raffsalvetti/ENGG60/projeto/Lista de símbolos.txt

$\theta$            Ângulo de Rotação
$\Delta_x$          Componente $x$ do Vetor de Rotação
$\Delta_y$          Componente $y$ do Vetor de Rotação
$\Delta_z$          Componente $z$ do Vetor de Rotação
$\Omega$            Ohm
V                   Volts
$\degree$           Grau
