raffsalvetti/ENGG60/projeto/pos-textuais/apendices.tex

% APÊNDICES--------------------------------------------------------------------

\begin{apendicesenv}
\partapendices

\includepdf[pages=-,offset=0 -20,angle=-90,scale=0.9,pagecommand={
	\chapter{Diagrama de Circuitos} % Edite para alterar o título deste apêndice
	\label{chap:board}
}]{../board/hat.pdf}

\chapter{Fotos do Protótipo} % Edite para alterar o título deste apêndice
\label{chap:fotosprototipo}

\begin{figure}[H]
	\centering
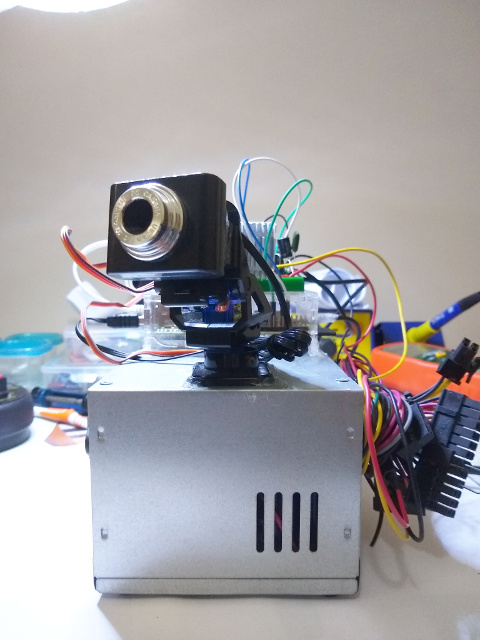
[picture p1: projeto/figuras/vista_frontal.jpg]
	
	\caption{Visão anterior.}
	\label{fig:vistafrontal}
\end{figure}

\begin{figure}[H]
	\centering
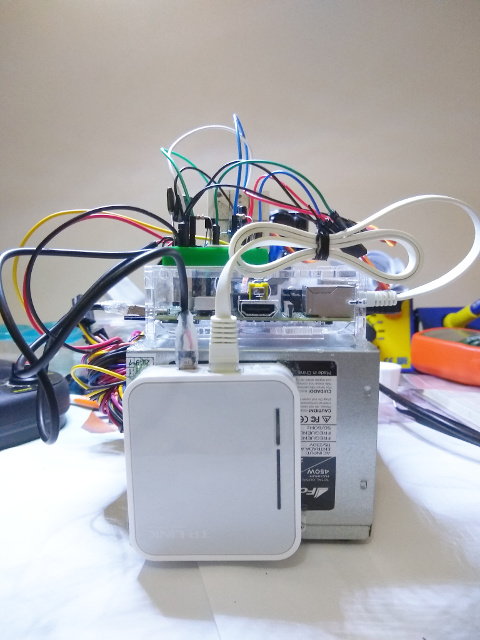
[picture p2: projeto/figuras/vista_traseira.jpg]
	
	\caption{Visão posterior.}
	\label{fig:vistatraseira}
\end{figure}

\begin{figure}[H]
	\centering
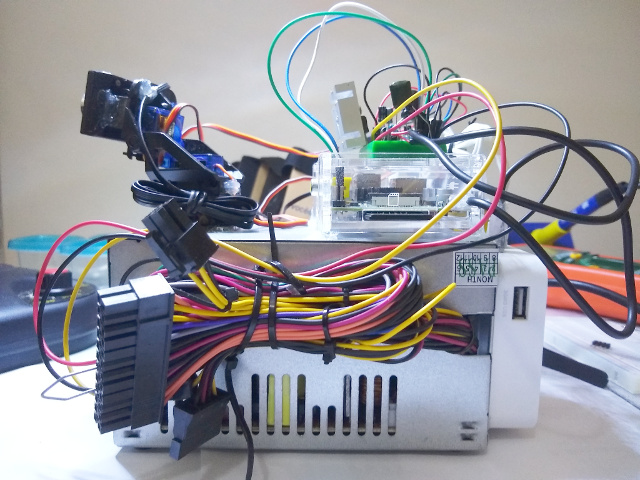
[picture p3: projeto/figuras/vista_esquerda.jpg]
	
	\caption{Visão lateral esquerda.}
	\label{fig:vistaesquerda}
\end{figure}

\begin{figure}[H]
	\centering
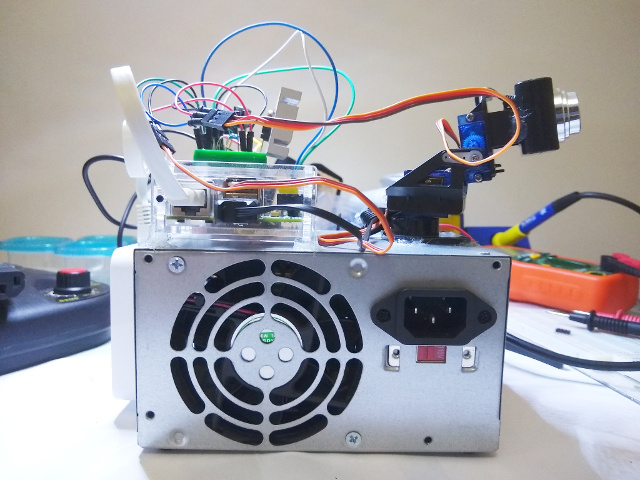
[picture p4: projeto/figuras/vista_direita.jpg]
	
	\caption{Visão lateral direita.}
	\label{fig:vistadireita}
\end{figure}

\begin{figure}[H]
	\centering
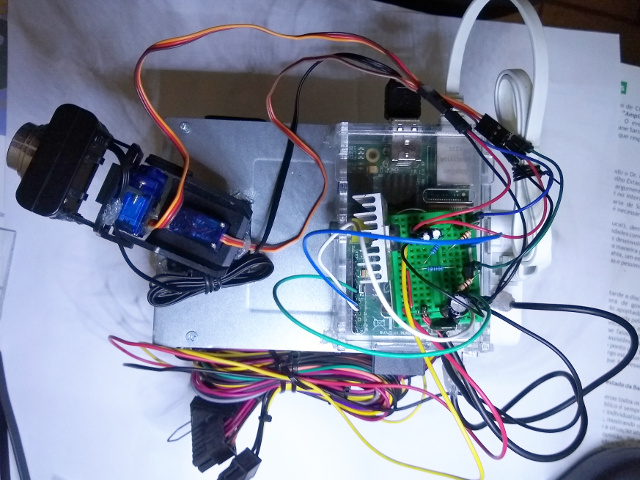
[picture p5: projeto/figuras/vista_superior.jpg]
	
	\caption{Visão superior.}
	\label{fig:vistasuperior}
\end{figure}

\begin{figure}[H]
	\centering
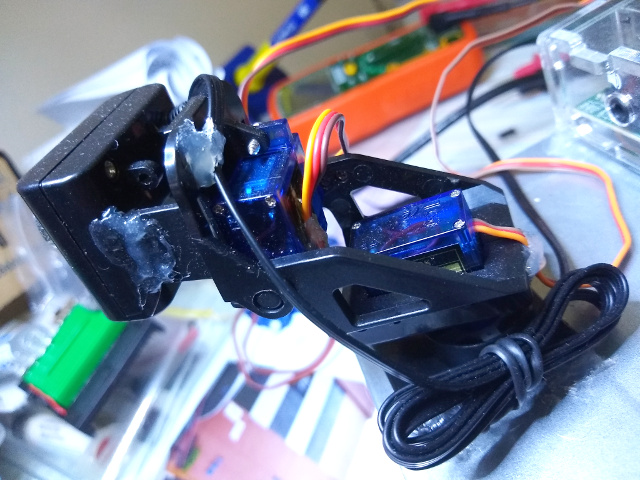
[picture p6: projeto/figuras/vista_detalhe_fixacao_camera.jpg]
	
	\caption{Fixação da câmera com cola quente.}
	\label{fig:vistadetalhefixacaocamera}
\end{figure}

\begin{figure}[H]
	\centering
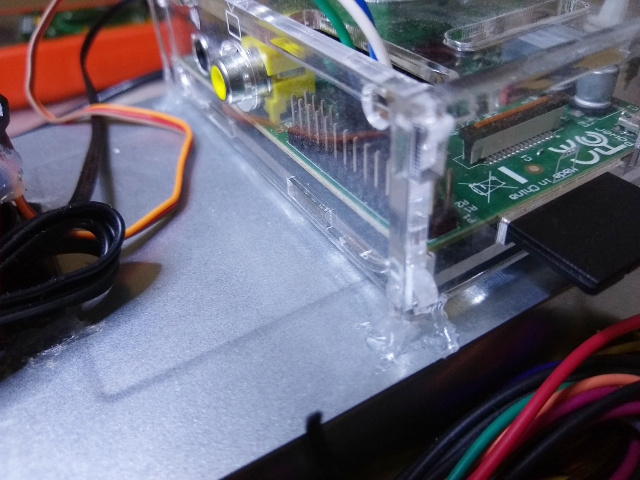
[picture p7: projeto/figuras/vista_detalhe_fixacao_raspi.jpg]
	
	\caption{Fixação do gabinete do \textit{Raspberry Pi} com cola quente.}
	\label{fig:vistadetalhefixacaoraspi}
\end{figure}

\begin{figure}[H]
	\centering
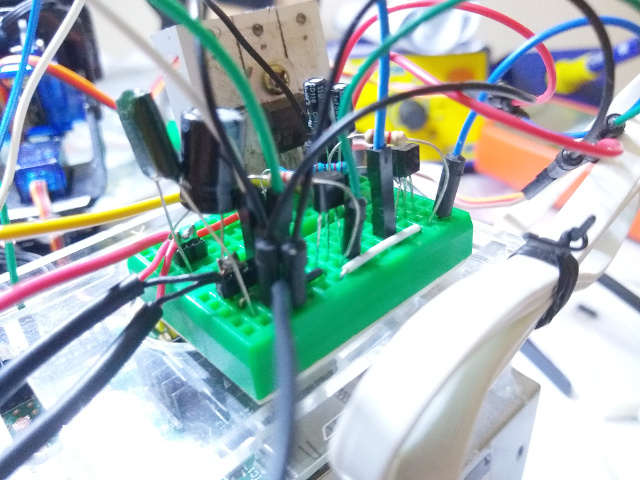
[picture p8: projeto/figuras/vista_detalhe_circuito.jpg]
	
	\caption{Detalhe da montagem do circuito na mini \textit{breadboard}.}
	\label{fig:vistadetalhecircuito}
\end{figure}

\end{apendicesenv}
