raffsalvetti/ENGG60/projeto/pre-textuais/lista-siglas.tex

% LISTA DE ABREVIATURAS E SIGLAS----------------------------------------------------------

\begin{siglas}
	\item[API]         Application Programming Interface
	\item[ARM]         Advanced RISC Machine
	\item[ATX]         Advanced Technology eXtended
	\item[DOF]         Degrees of freedom
	\item[GPIO]        General-Purpose Input/Output
	\item[HAL]         Hardware Abstraction Layer
	\item[IP]          Internet Protocol
	\item[MCC]         Módulo de Controle de Câmera
	\item[MCM]         Módulo de Captura de Movimento
	\item[PAN]         Panning
	\item[PSU]         Power Supply Unit
	\item[PWM]         Pulse-Width Modulation
	\item[RAM]         Random Access memory
	\item[ROS]		   Robot Operating System
	\item[RTP]         Real Time Protocol
	\item[SoC]         System on Chip
	\item[TCP]         Transmission Control Protocol
	\item[TILT]        Tilting
	\item[VLC]         VideoLAN Client
	\item[VR]          Virtual Reality
\end{siglas}

% OBSERVAÇÕES-----------------------------------------------------------------------------
% Altere a lista acima para definir os acrônimos e siglas utilizados neste trabalho
