raffsalvetti/ENGG60/apresentacao/tcc.odp

## UNIVERSIDADE FEDERAL DA BAHIA ESCOLA POLITÉCNICA CURSO DE GRADUAÇÃO EM ENGENHARIA DE COMPUTAÇÃO

## CONTROLE DO MOVIMENTO DE CÂMERA COM BASE EM SENSORES DE MOVIMENTO DE UM SMARTPHONE

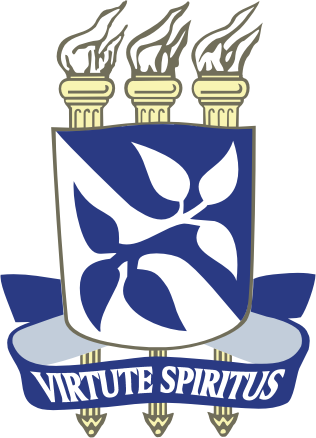
[picture p32: figure]

Autor: Raffaello Salvetti Santos

Orientador: Prof. Paulo César Machado de Abreu Farias

Salvador (BA), Dezembro de 2019

## Introdução

- Uso de robôs está cada vez mais popular.
- A complexidade de operação de um robô é proporcional ao seu DOF.
- uma câmera controlada independentemente da orientação de um robô, pode facilitar tarefas de localização num ambiente.

## Objetivos

- Redução da complexidade de controle de um robô.
- Controle intuitiva de câmera.
- Imersividade do operador.

## Inspiração

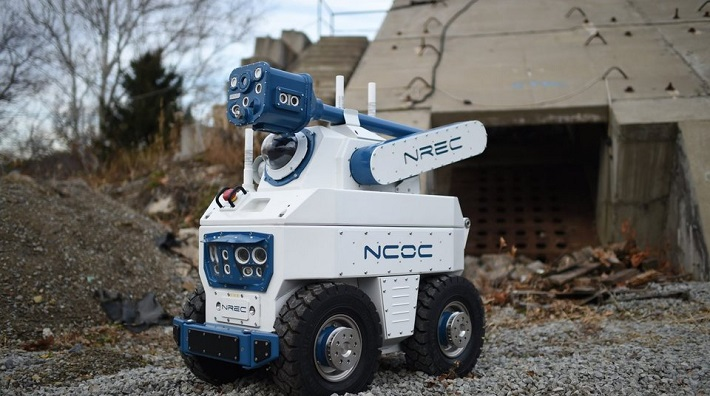
[picture p33: figure]

SENSABOT

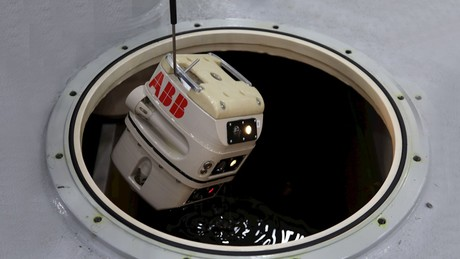
[picture p34: figure]

ABB

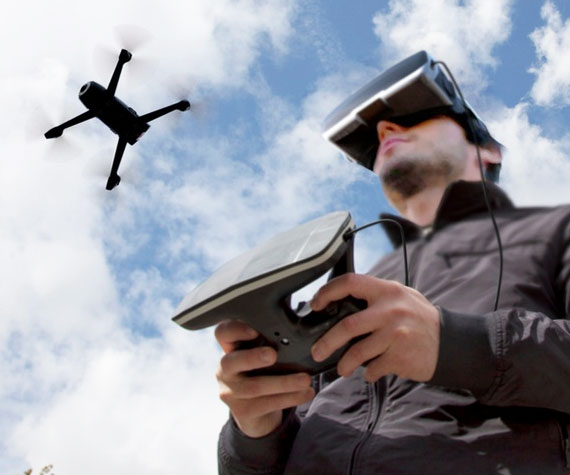
[picture p35: figure]

Sistema FPV

## Conceito - Cardboard


Smartphone Android


Óculos VR (Google Cardboard)

## Conceito – Controlador


Raspberry Pi

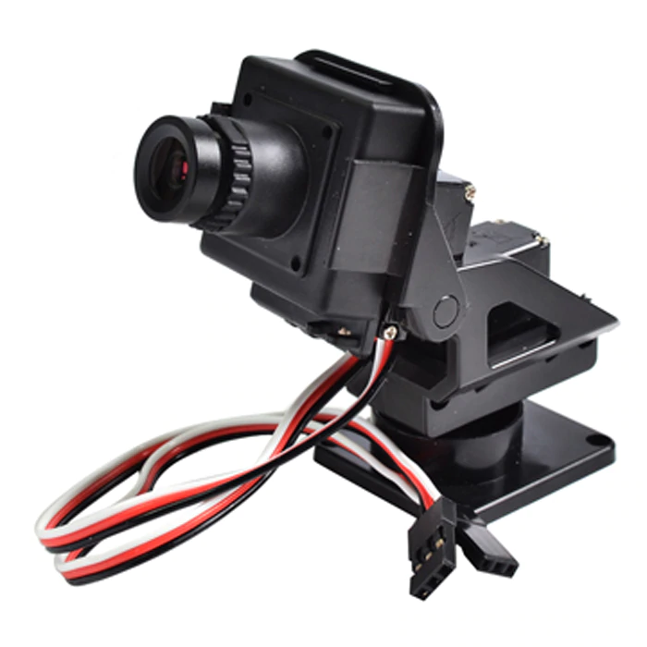
[picture p36: figure]

CÂMERA COM MONTAGEM E SERVO MOTORES

## Conceito - Funcionamento

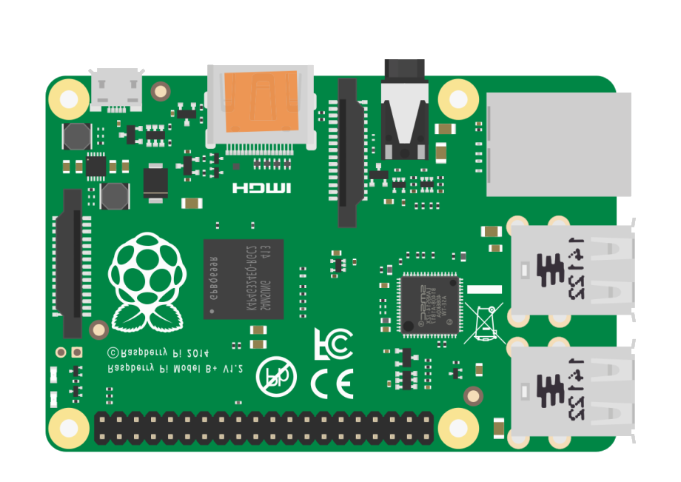
[picture p37: figure]
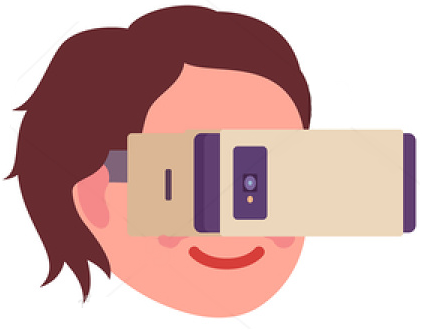
[picture p38: figure]
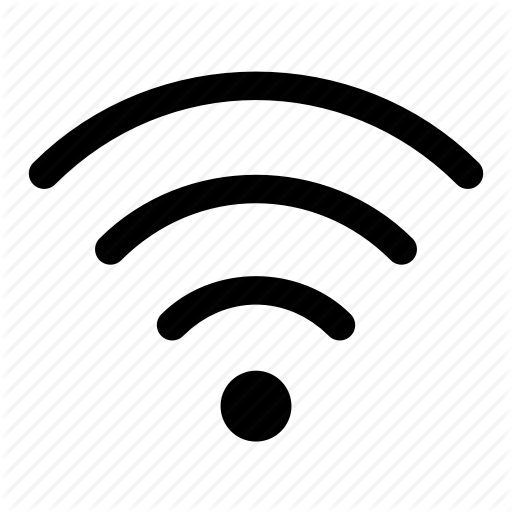
[picture p39: figure]
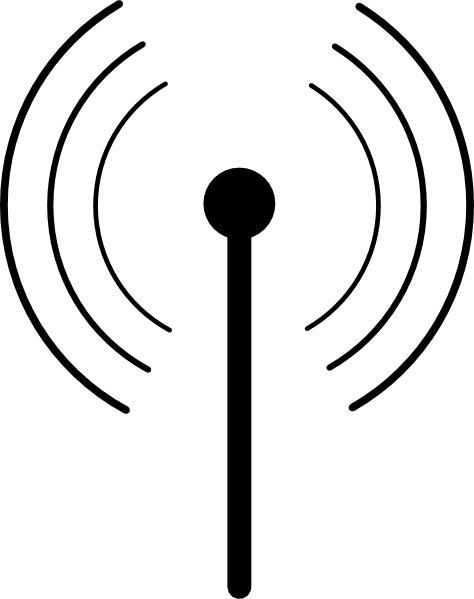
[picture p40: figure]
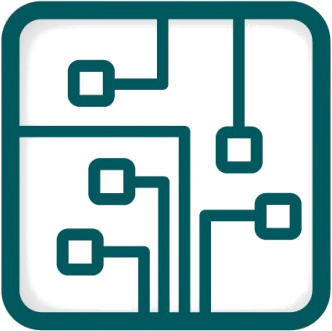
[picture p41: figure]
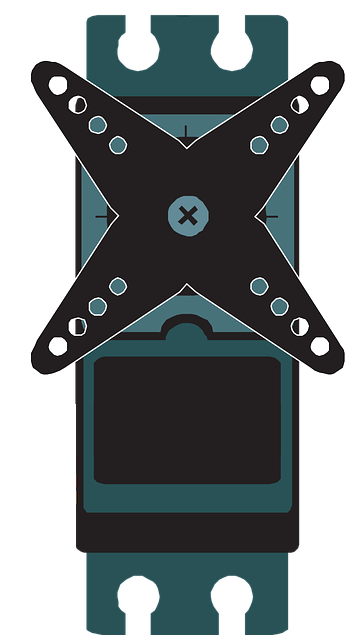
[picture p42: figure]
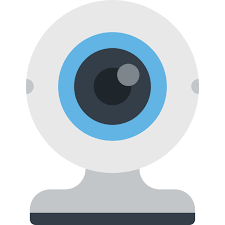
[picture p43: figure]

## Conceito – Tradução de Movimentos

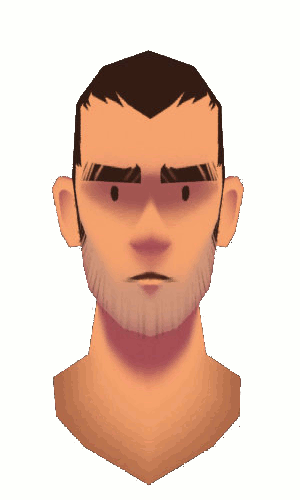
[picture p44: figure]
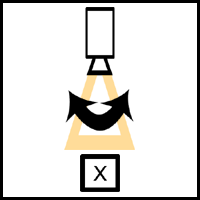
[picture p45: figure]
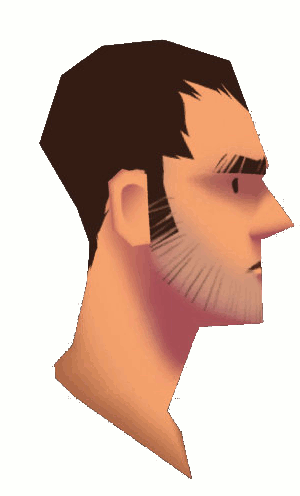
[picture p46: figure]
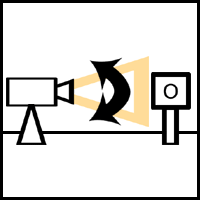
[picture p47: figure]

## Protótipo

- Construção de circuito de teste para os servo motores;
- Teste de frequência de operação e estabilidade dos servo motores;
- Construção de circuitos de acionamento e alimentação;
- Construção do protótipo;
- Programação dos softwares;
- Testes gerais.

## Protótipo – Driver PWM

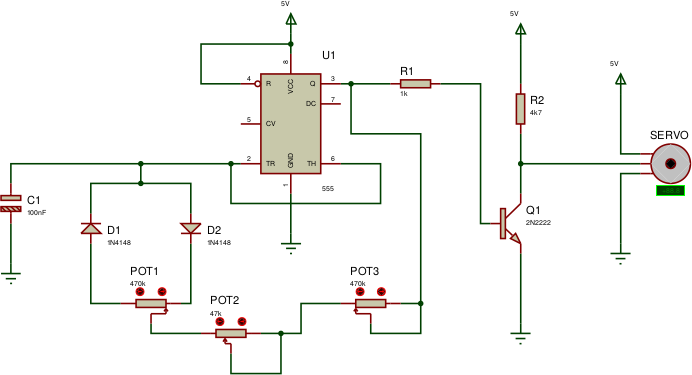
[picture p48: figure]

Circuito de teste dos motores.

## Protótipo – Driver PWM Resultados dos Testes

- Estabilidade com frequências próximas a 50Hz.
- Instabilidade com variações da largura do pulso.

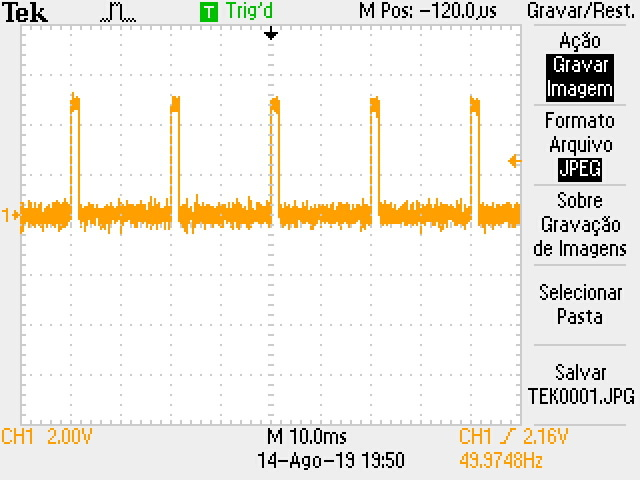
[picture p49: figure]

Teste do sinal com um osciloscópio.

## Protótipo – Circuitos de Acionamento e Alimentação

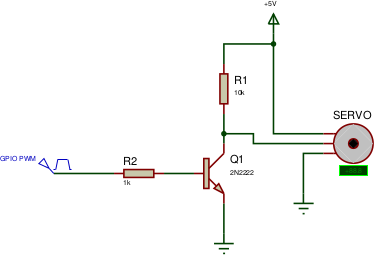
[picture p50: figure]

Circuito de Acionamento

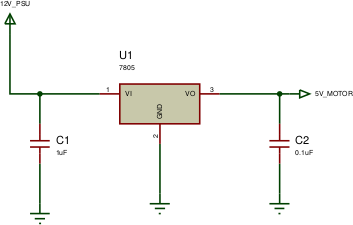
[picture p51: figure]

Circuito de Alimentação

## Protótipo – Montagem (Visão Lateral)


Visão lateral direita do protótipo.

## Protótipo – Montagem (Visão Superior)


Visão superior do protótipo.

## Protótipo – Montagem (Visões Posterior e Anterior)


Visão posterior do protótipo.


Visão anterior do protótipo.

## Programação - MCM


Interface com o usuário (operador) do MCM.

## Programação - MCC

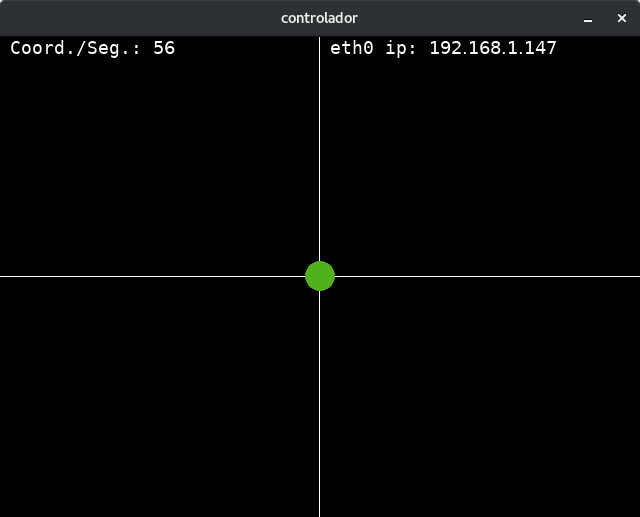
[picture p52: figure]

Interface de testes do MCC

## Programação – MCC (CAMDEMO)

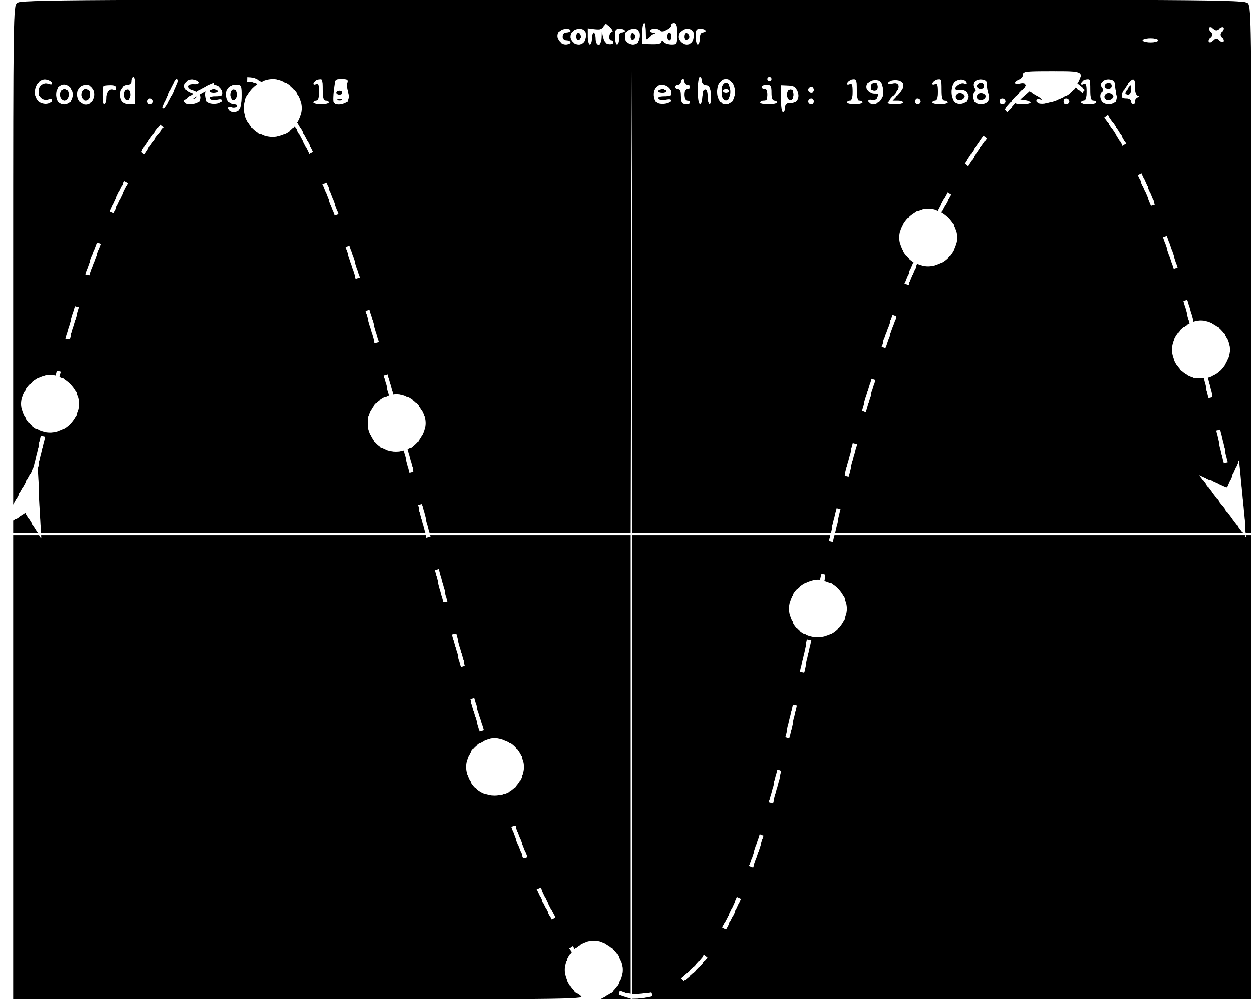
[picture p53: figure]

Função automática de teste dos motores (CAMDEMO)

## Testes Gerais

- Codecs de vídeo;
- Consumo de banda (dados de controle e imagens);
- Envio de imagem capturada pela câmera;
- Teste de servo motores.

## Teste – Codecs de Vídeo

Ffmpeg usando o codec de vídeo h264 (implementado em software).

Ffmpeg usando o codec de vídeo h264_omx (implementado em hardware).

## Teste – Consumo de Dados

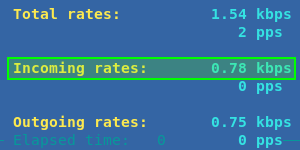
[picture p54: figure]

Envio de Coordenadas (Com Filtro).

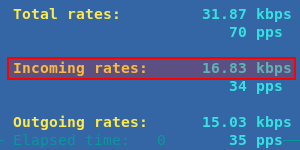
[picture p55: figure]

Envio de Coordenadas (Sem Filtro).

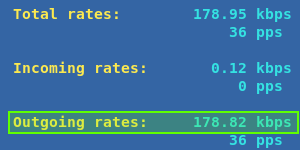
[picture p56: figure]

Envio de imagens de vídeo.

## Teste – Imagens da câmera


Imagem enviada pela câmera.

## Teste – Servo Motores

## Teste – Servo Motores Correção no movimento

## Resultados

## Conclusão

- Os testes demonstram que o sistema pode ser utilizado para reduzir a complexidade do controle global de um robô.
- O controle de câmera é realizado de forma intuitiva.
- É necessário aprimorar o sistema de transmissão de vídeo para que o operador tenha a sensação de imersividade.

## Referências

HUGHES, S.; LEWIS, M. Robotic camera control for remote exploration. In: ACM. Proceedings of the SIGCHI conference on Human factors in computing systems. [S.l.], 2004. p. 511-517.

AMADEO, R. Google’s iron grip on Android: Controlling open source by any means necessary. 2018. Disponível em:< https://arstechnica.com/gadgets/2018/07/googles-iron-grip-on-android-controlling-open-source-by-any-means-necessary/>.

ANDROID.COM. What is Android. 2019. Disponível em: <https://www.android.com/what-is-android>

DEVELOPERS, G. A. Motion sensors. 2019. Disponível em: <https://developer.android.com/guide/topics/sensors/sensors motion>

DOMAIN, P. Pan and Tilt. 2019. Disponível em: <https://pt.wikipedia.org/wiki/Panor%C3%A2mica (https://pt.wikipedia.org/wiki/Panorâmica)>

LAMPERT, K. Modular Head. 2019. Disponível em: <https://www.artstation.com/artwork/31rg>

PINCKNEY, N. Pulse-width modulation for microcontroller servo control. IEEE potentials, IEEE, v. 25, n. 1, p. 27-29, 2006.
