raffsalvetti/ENGG60/projeto/figuras/diagrama-modulos-eps-converted-to.pdf

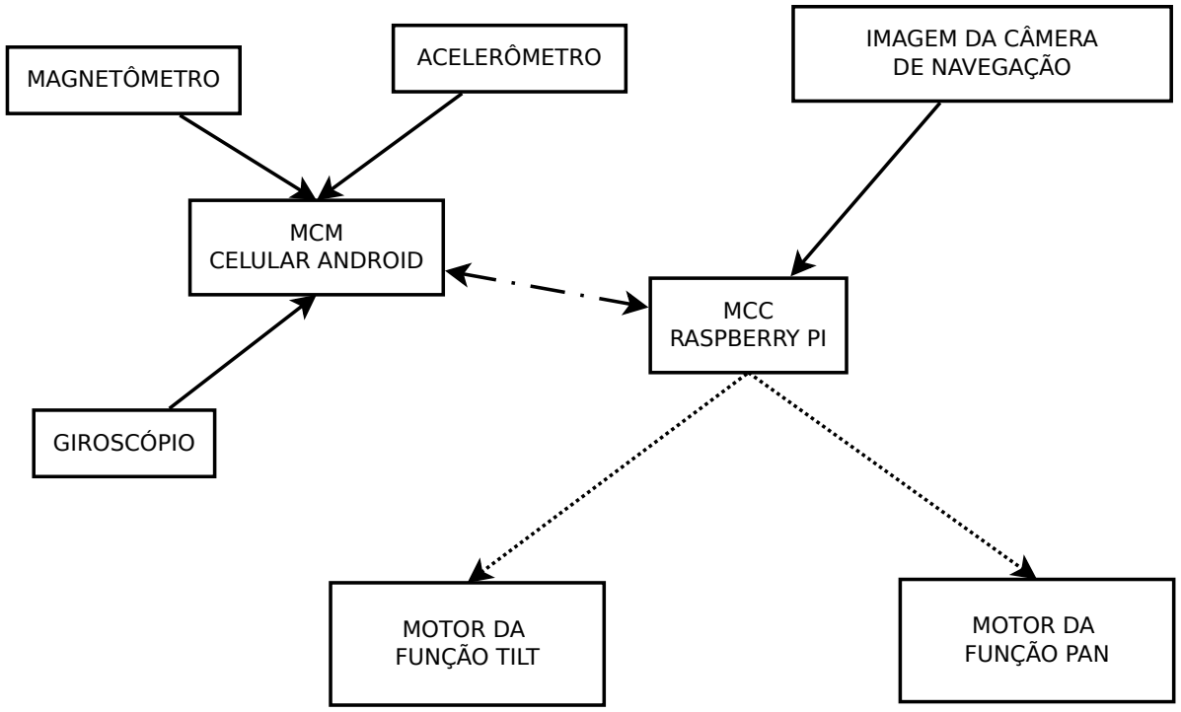
[picture p58: figure]
MCM CELULAR ANDROID; MCC RASPBERRY PI; MOTOR DA FUNÇÃO TILT; IMAGEM DA CÂMERA DE NAVEGAÇÃO; GIROSCÓPIO; MOTOR DA FUNÇÃO PAN; MAGNETÔMETRO; ACELERÔMETRO

LEGENDA:

COMUNICAÇÃO ETHERNET
COMUNICAÇÃO SERIAL
COMUNICAÇÃO PWM
