raffsalvetti/ENGG60/projeto/figuras/circ_acionamento.pdf

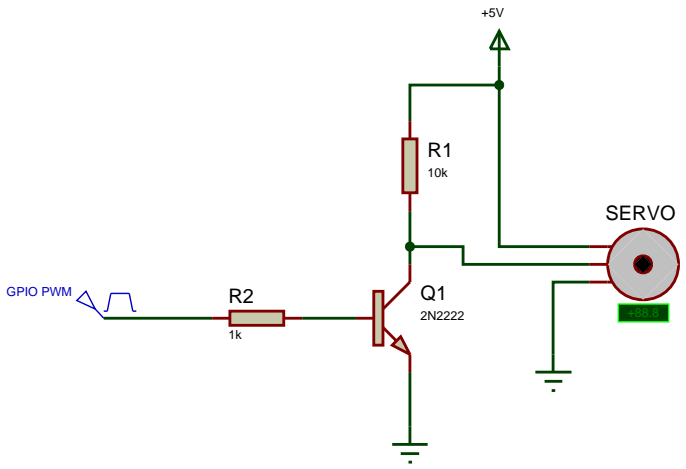
[picture p59: figure]
SERVO; GPIO PWM
