raffsalvetti/ENGG60/projeto/figuras/fonte_motores.pdf

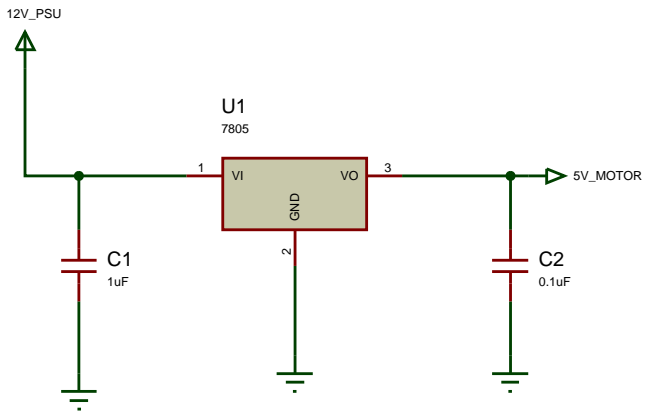
[picture p60: figure]
12V_PSU; GND 2; 5V_MOTOR
