raffsalvetti/ENGG60/projeto/pre-textuais/agradecimentos.tex

% AGRADECIMENTOS---------------------------------------------------------------

\begin{agradecimentos}[AGRADECIMENTOS]

Agradeço à Deus por permitir que eu chegasse até aqui. À minha família, em especial à minha mãe Sonia e ao meu pai Rui, que se esforçaram para me proporcionar conforto e educação. À minha irmã Alessandra, meus avós Lori e Luigi, às minhas tias Silvana e Zete, que incentivaram minha criatividade desde criança. À Mariana, minha companheira que sempre esteve ao meu lado, com bastante paciência, me apoiando e ajudando a vencer batalhas. Aos meus sogros Eugênio e Luiza, e cunhado Francisco que me acolheram e torceram muito por mim durante essa jornada. Aos meus amigos que estiveram junto também nas horas de dificuldade. Agradeço ao professor Heraldo, que muito contribuiu para minha formação intelectual e me apontou o caminho ainda no ensino médio. Ao meu orientador Paulo César, pelo suporte necessário para a realização deste trabalho. À Universidade Federal da Bahia e sua equipe de excelentes professores, com os quais tive a oportunidade de aprender. Por fim, agradeço aos meus colegas de curso, principalmente à Felipe, Luciano e Hugo, que tornaram essa caminhada mais descontraída.

\end{agradecimentos}
