raffsalvetti/ENGG60/projeto/pre-textuais/folha-aprovacao.tex

% ---
% Inserir folha de aprovação
% ---
% Isto é um exemplo de Folha de aprovação, elemento obrigatório da NBR
% 14724/2011 (seção 4.2.1.3). Você pode utilizar este modelo até a aprovação do trabalho. Após isso, substitua todo o conteúdo deste arquivo por uma imagem da página assinada pela banca com o comando abaixo:
%
% \includepdf{folhadeaprovacao_final.pdf}
%

%\dataaprovacao{00/00/0000}
%\conceito{} %Antes da defesa, não adicionar valor ao compo. Após a defesa, pode-se adicionar Regular, Bom ou Excelente e solicitar as assinaturas da banca examinadora.
 
\nomePrimeiromembro{Prof. Jés de Jesus Fiais Cerqueira}
\instPrimeiromembro{UFBA}
 
\nomeSegundomembro{Prof. Tiago Trindade Ribeiro}
\instSegundomembro{UFBA}

%Ocultar ou não dependendo do número de professores na banca. Ver arquivo de configuracao \assinatura{\imprimirnomeTerceiromembro  \\ Membro - \imprimirinstTerceiromembro}  nas configuracoes ufpa-fem-abntex2.cls.

%\nomeTerceiromembro{Eng. Beltrano Cunha} 
%\instTerceiromembro{Externo (PETROBRAS)}

%ª
