raffsalvetti/ENGG60/projeto/pre-textuais/lista-simbolos.tex

% LISTA DE SÍMBOLOS------------------------------------------------------------

\begin{simbolos}
    \item[$ \theta $] Ângulo de Rotação
    \item[$ \Delta_x $] Componente $x$ do Vetor de Rotação
    \item[$ \Delta_y $] Componente $y$ do Vetor de Rotação
    \item[$ \Delta_z $] Componente $z$ do Vetor de Rotação
    \item[$K\Omega$] Quilo-ohms
    \item[$V$] Volts
    \item[$mA$] Miliampere    
    \item[$\degree$] Grau
\end{simbolos}
% OBSERVAÇÕES-------------------------------------------------------------------
% Altere a lista acima para definir os símbolos utilizados no trabalho
