raffsalvetti/ENGG60/projeto/pre-textuais/capa.tex

% CAPA-------------------------------------------------------------------

% ORIENTAÇÕES GERAIS-------------------------------------------------------------------------------------
% Caso algum dos campos não se aplique ao seu trabalho, como por exemplo,
% se não houve coorientador, apenas deixe vazio.
% Exemplos: 
% \coorientador{}
% \departamento{}

% DADOS DO TRABALHO--------------------------------------------------------------------------------------
\titulo{\textbf{CONTROLE DO MOVIMENTO DE CÂMERA COM BASE EM SENSORES DE MOVIMENTO DE UM \textit{SMARTPHONE}}}
\subtitulo{} %Se não hover subtítulo, deixar em branco.
\titleabstract{CAMERA MOTION CONTROL BASED ON MOBILE PHONE SENSORS DATA}
\autor{RAFFAELLO SALVETTI SANTOS}
\autorcitacao{SALVETTI, Raffaello} % Sobrenome em maiúsculo
\local{SALVADOR/BA}
\data{2019}

% NATUREZA DO TRABALHO-----------------------------------------------------------------------------------
\projeto{Trabalho de Conclusão de Curso}

% TÍTULO ACADÊMICO---------------------------------------------------------------------------------------
\tituloAcademico{Bacharel}

% ÁREA DE CONCENTRAÇÃO E LINHA DE PESQUISA---------------------------------------------------------------
% Se a natureza for Trabalho de Conclusão de Curso, deixe ambos os campos vazios
% Se for programa de Pós-graduação, indique a área de concentração e a linha de pesquisa
\areaconcentracao{}
\linhapesquisa{}

% DADOS DA INSTITUIÇÃO-----------------------------------------------------------------------------------
% Se a natureza for Trabalho de Conclusão de Curso, coloque o nome do curso de graduação em "programa"
% Formato para o logo da Instituição: \logoinstituicao{<escala>}{<caminho/nome do arquivo>}
\instituicao{Universidade Federal da Bahia}
\departamento{Escola Politécnica}
\programa{Curso de Graduação em Engenharia de Computação}
\logoinstituicao{2cm}{figuras/naomexafig/logoufba.png} %

% DADOS DOS ORIENTADORES---------------------------------------------------------------------------------
\orientador{Prof. Paulo César Machado de Abreu Farias}
%\orientador[Orientadora:]{Nome da orientadora}
\instOrientador{Universidade Federal da Bahia}

%\coorientador{Nome do coorientador}
%\coorientador[Coorientadora:]{Nome da coorientadora}
%\instCoorientador{Instituição do coorientador}
