raffsalvetti/ENGG60/projeto/pos-textuais/naomexapostext/referencias.tex

% REFERÊNCIAS------------------------------------------------------------------

% Carrega o arquivo "base-referências.bib" e extrai automaticamente as referências citadas

\bibliography{./base-referencias}
\bibliographystyle{abntex2-alf} % Define o estilo ABNT para formatar a lista de referências
% OBSERVAÇÕES------------------------------------------------------------------
% Este arquivo não precisa ser alterado.
