raffsalvetti/ENGG60/projeto/pre-textuais/naomexapretext/folha-rosto.tex

% FOLHA DE ROSTO-------------------------------------------------------------------

% Este arquivo não precisa ser alterado

%% TRABALHO DE CONCLUSÃO DE CURSO
\preambulo{{\imprimirprojeto}, apresentado como parte dos requisitos para a obtenção de grau de {\imprimirtituloAcademico} em Engenharia de Computação, pela {\imprimirinstituicao}.}
