raffsalvetti/ENGG60/preprojeto/modelo.pdf

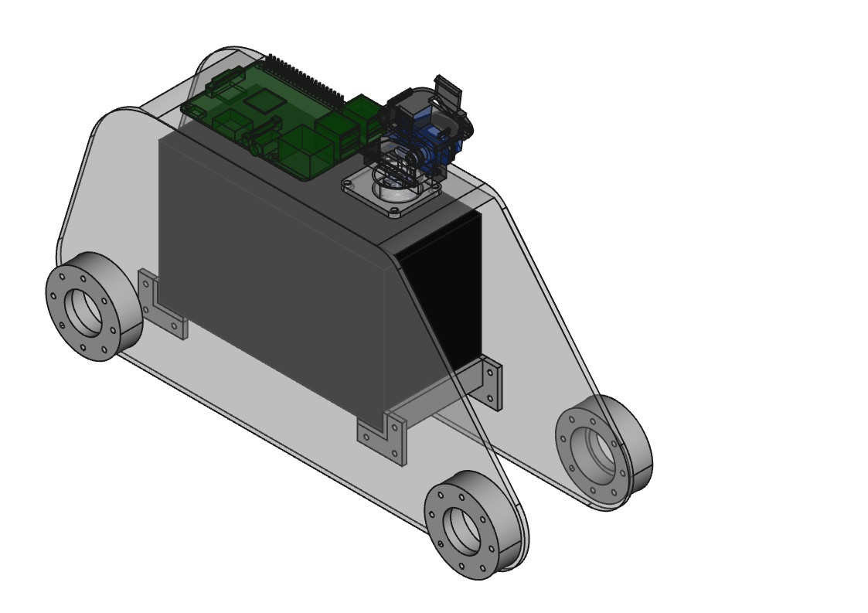
[picture p78: page 1]
