raffsalvetti/ENGG60/apresentacao/raspi.png

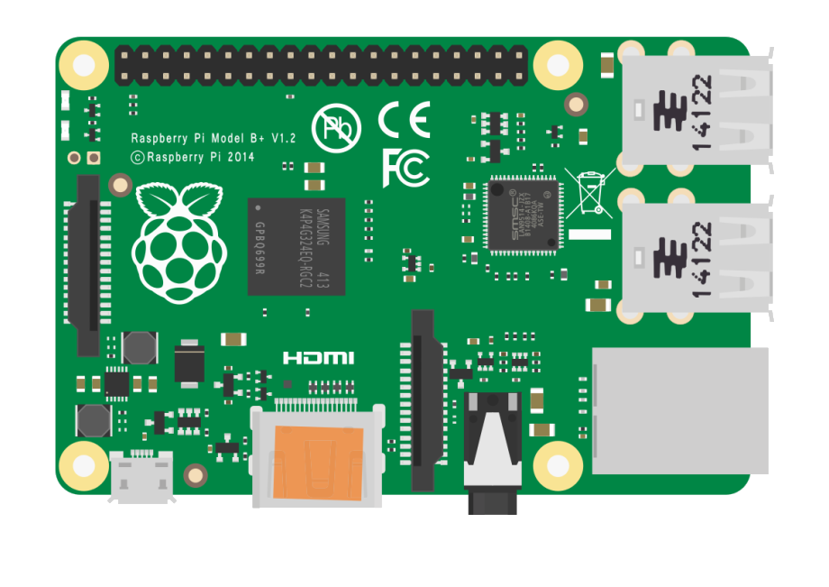
apresentacao/raspi.png
