raffsalvetti/ENGG60/apresentacao/SKEYE-Nano-drone.jpg

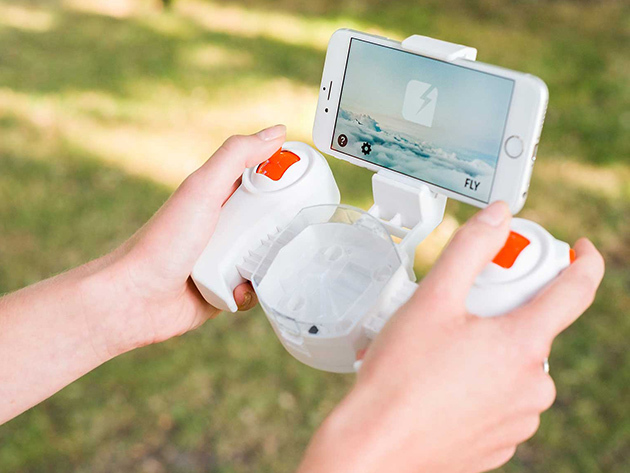
apresentacao/SKEYE-Nano-drone.jpg
