raffsalvetti/ENGG60/apresentacao/wireless.jpg

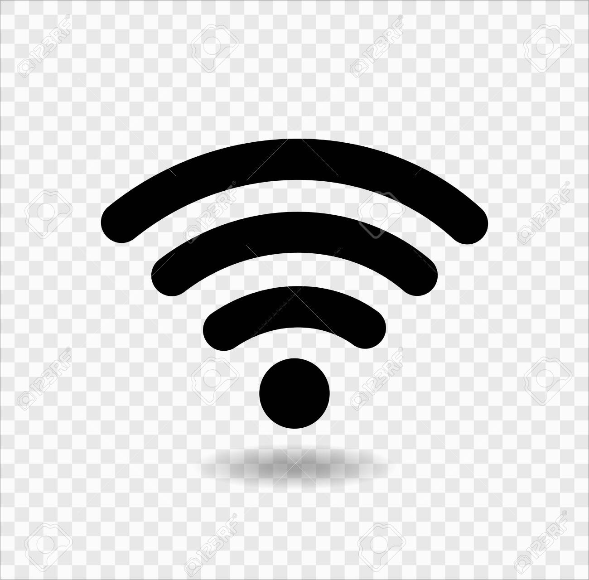
apresentacao/wireless.jpg
