raffsalvetti/ENGG60/projeto/figuras/arrow2.png

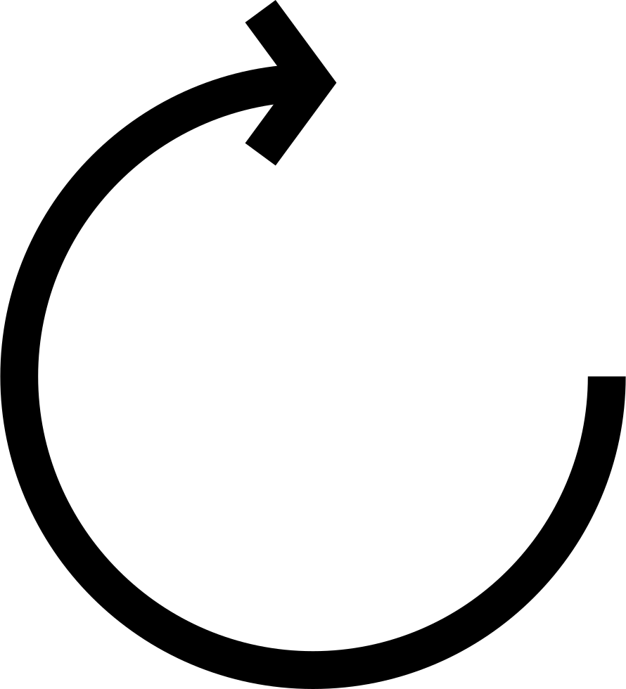
projeto/figuras/arrow2.png
