raffsalvetti/ENGG60/projeto/figuras/arrow.png

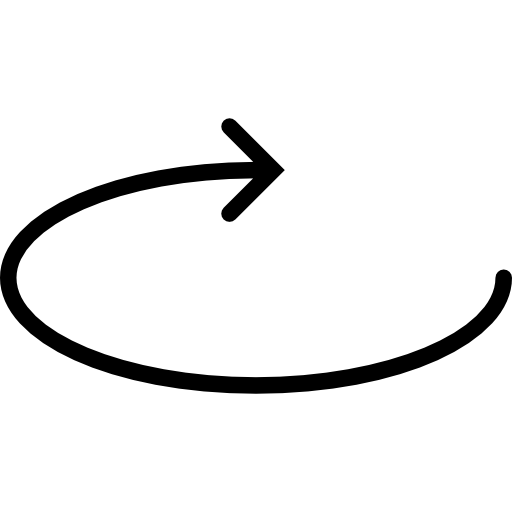
projeto/figuras/arrow.png
