raffsalvetti/ENGG60/projeto/figuras/base1.jpg

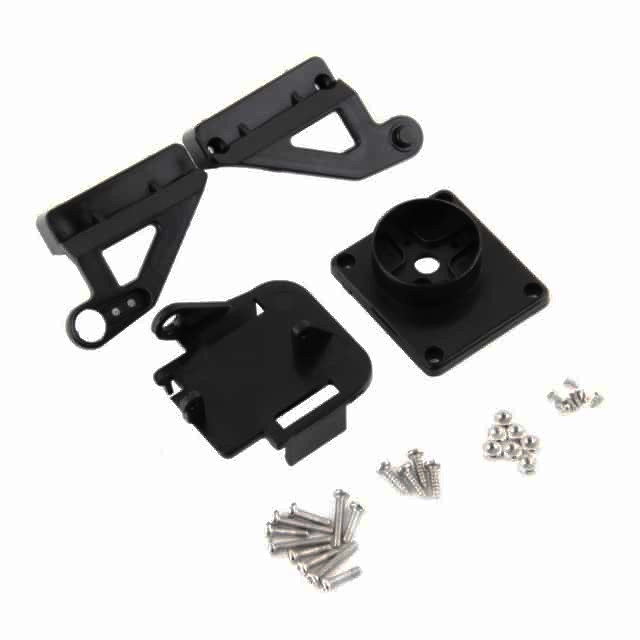
projeto/figuras/base1.jpg
