raffsalvetti/ENGG60/projeto/figuras/cameem_dec.png

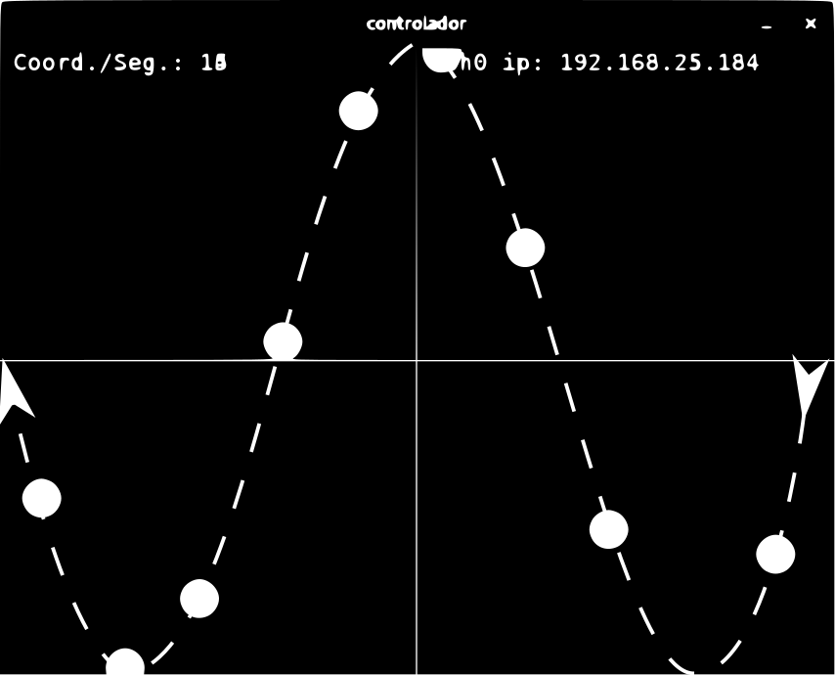
projeto/figuras/cameem_dec.png
