raffsalvetti/ENGG60/projeto/figuras/cameem_inc.png

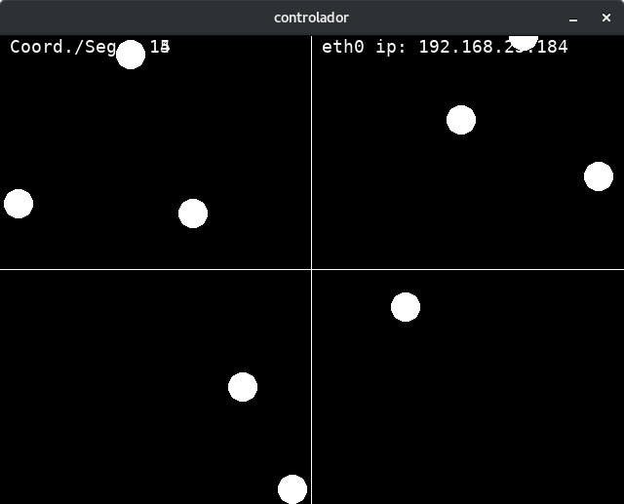
projeto/figuras/cameem_inc.png
