raffsalvetti/ENGG60/projeto/figuras/consumo_banda.jpg

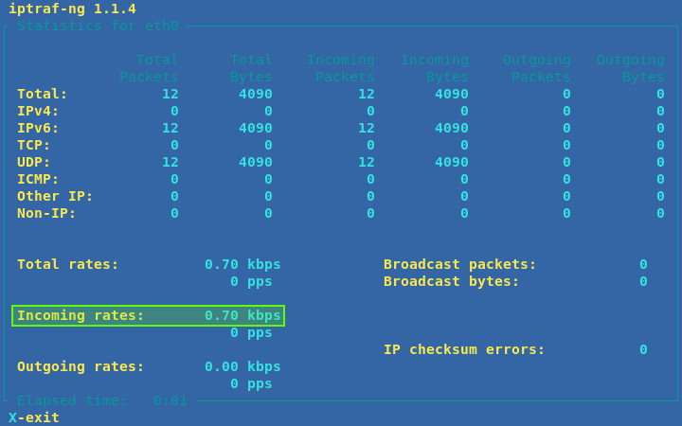
projeto/figuras/consumo_banda.jpg
