raffsalvetti/ENGG60/projeto/figuras/IMG_20191116_235842188.jpg

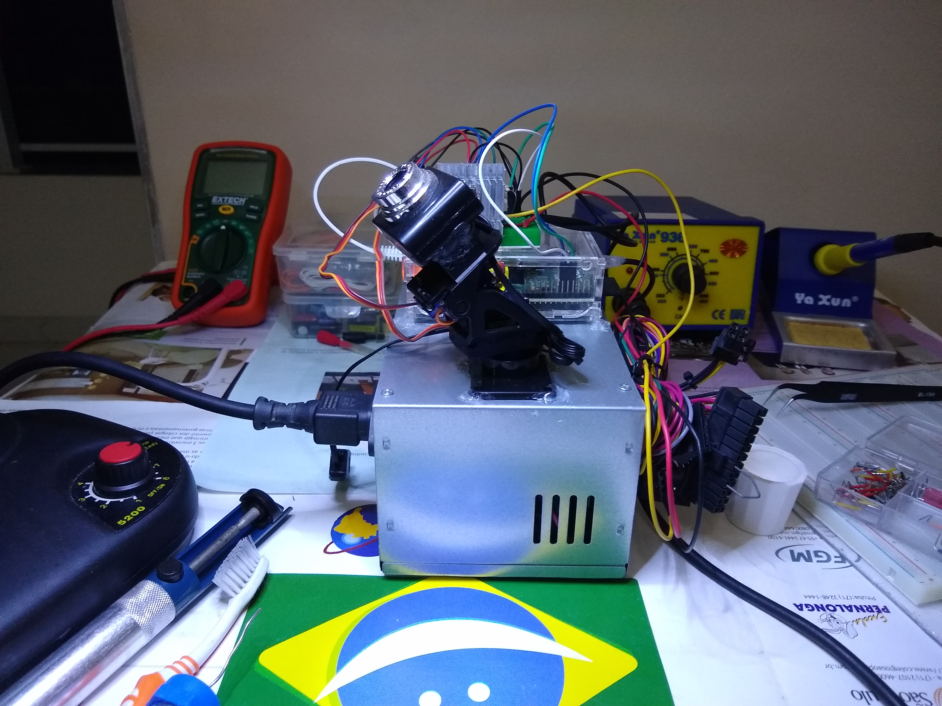
projeto/figuras/IMG_20191116_235842188.jpg
