raffsalvetti/ENGG60/projeto/figuras/IMG_20191116_235910755.jpg

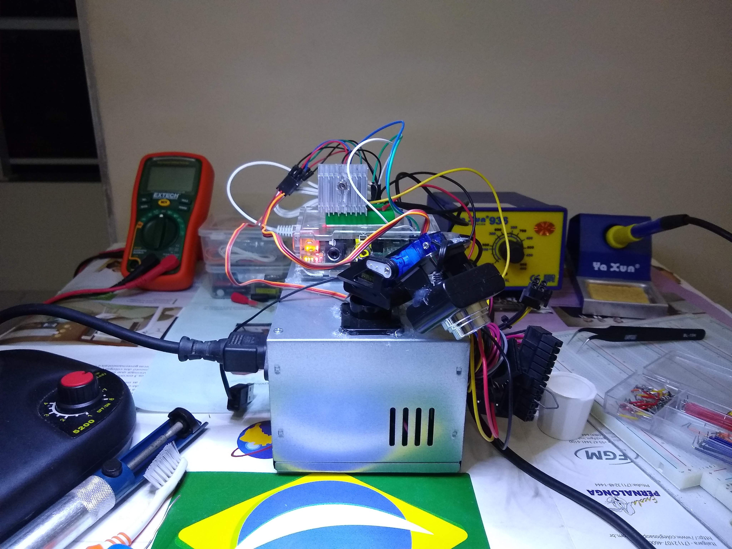
projeto/figuras/IMG_20191116_235910755.jpg
