raffsalvetti/ENGG60/projeto/figuras/IMG_20191120_085126943.jpg

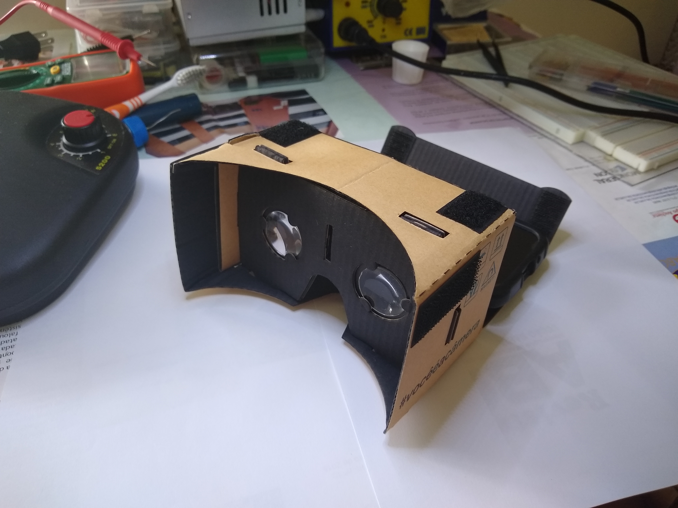
projeto/figuras/IMG_20191120_085126943.jpg
