raffsalvetti/ENGG60/projeto/figuras/IMG_20191120_085157293.jpg

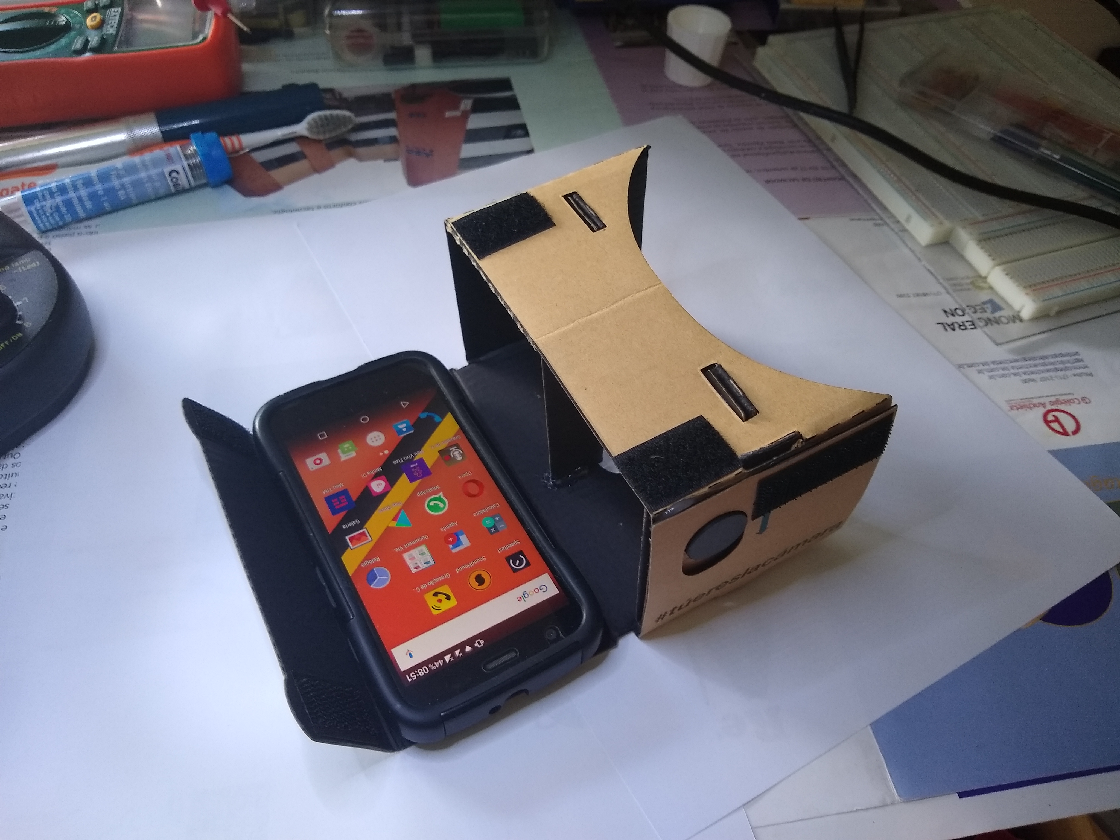
projeto/figuras/IMG_20191120_085157293.jpg
