raffsalvetti/ENGG60/projeto/figuras/modular_head.jpg

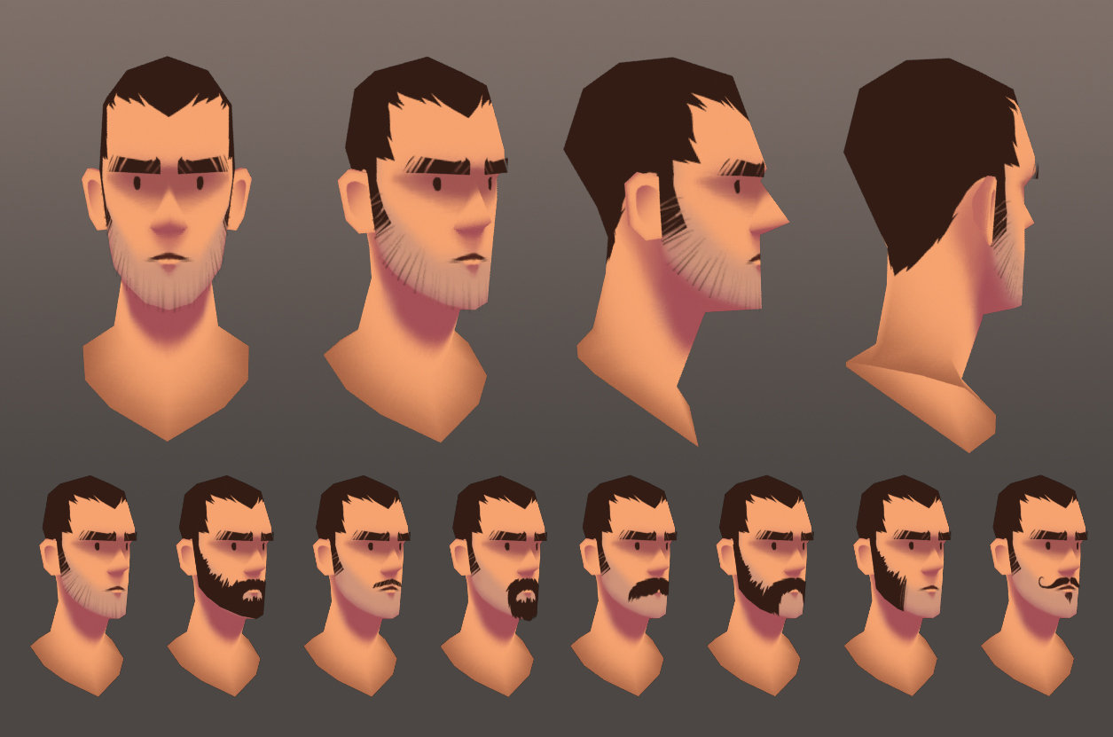
projeto/figuras/modular_head.jpg
