raffsalvetti/ENGG60/projeto/figuras/naomexafig/images.jpeg

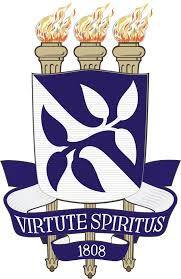
projeto/figuras/naomexafig/images.jpeg
