raffsalvetti/ENGG60/projeto/figuras/pwm_tensao_media.png

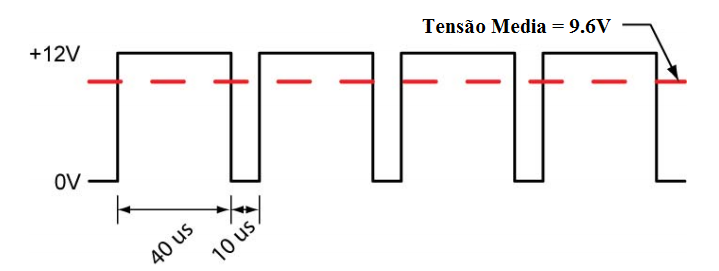
projeto/figuras/pwm_tensao_media.png
