raffsalvetti/ENGG60/preprojeto/modelo3d/modelo_v2.0.fcstd

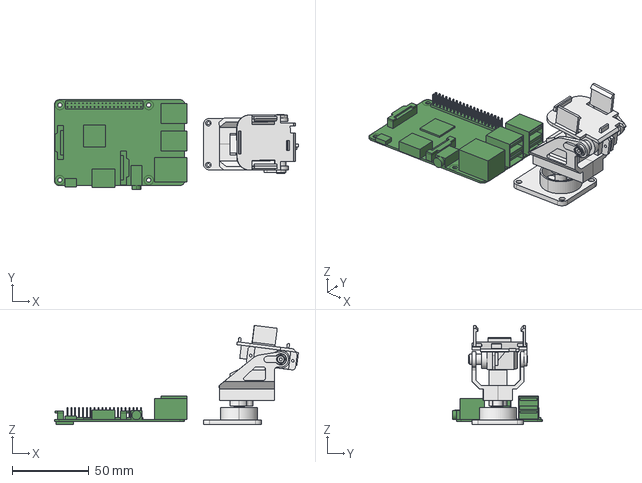
[picture p95: CAD file, 2019-08-31]
preprojeto/modelo3d/modelo_v2.0.fcstd
159.3 x 58.5 x 64.7 mm
suporte_camera
