raffsalvetti/ENGG60/preprojeto/modelo3d/JLB Stepper Motor 17HS1352-P4130.STEP

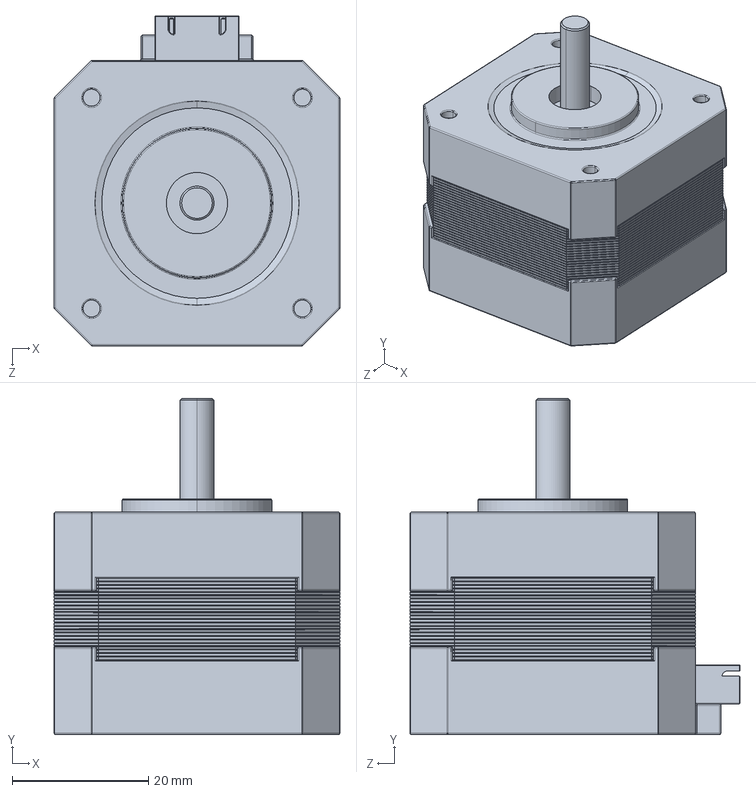
[picture p96: CAD file, 2018-04-20]
preprojeto/modelo3d/JLB Stepper Motor 17HS1352-P4130.STEP
42.0 x 49.4 x 48.5 mm
