raffsalvetti/ENGG60/preprojeto/modelo3d/NEMA Stepper.STEP

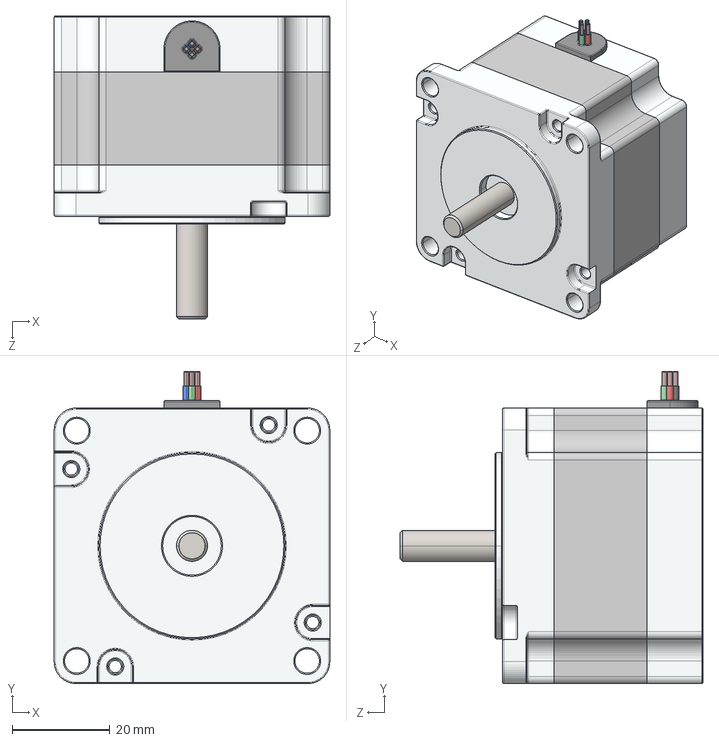
[picture p97: CAD file, 2018-04-20]
preprojeto/modelo3d/NEMA Stepper.STEP
56.4 x 63.9 x 62.0 mm
