raffsalvetti/ENGG60/preprojeto/modelo3d/chain.STEP

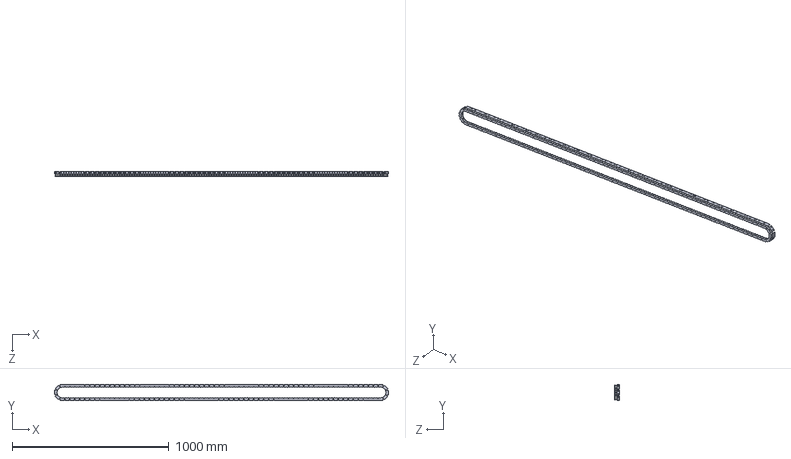
[picture p98: CAD file, 2018-04-16]
preprojeto/modelo3d/chain.STEP
2133.3 x 102.8 x 32.1 mm
link1 x 136
link2 x 136
