raffsalvetti/ENGG60/preprojeto/modelo3d/Raspberry Pi (V.1.2) B+.STEP

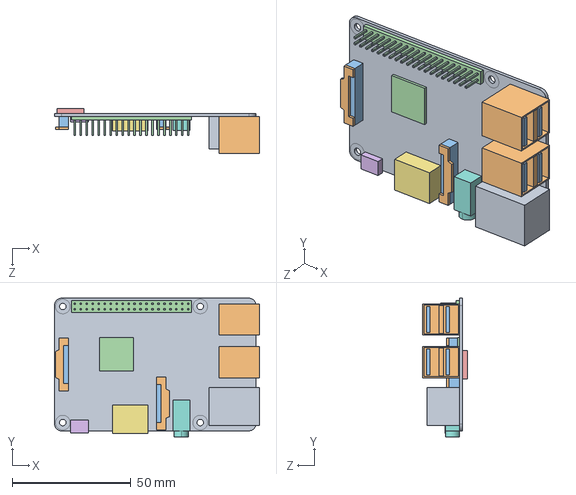
[picture p99: CAD file, 2018-04-15]
preprojeto/modelo3d/Raspberry Pi (V.1.2) B+.STEP
86.5 x 58.5 x 18.8 mm
