raffsalvetti/ENGG60/preprojeto/modelo3d/RuncamSwiftMicro PanTilt-1.stp

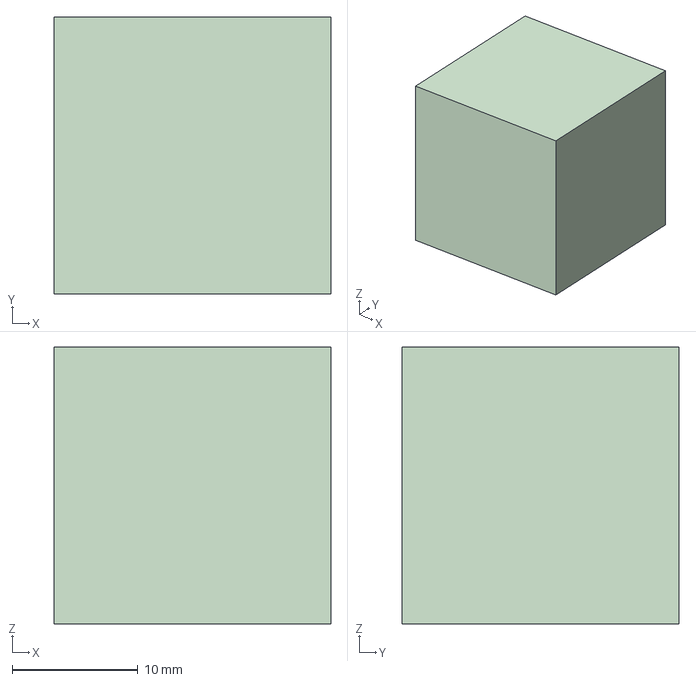
[picture p101: CAD file, 2018-04-15]
preprojeto/modelo3d/RuncamSwiftMicro PanTilt-1.stp
22.0 x 22.0 x 22.0 mm
