raffsalvetti/ENGG60/preprojeto/modelo3d/modelo.fcstd

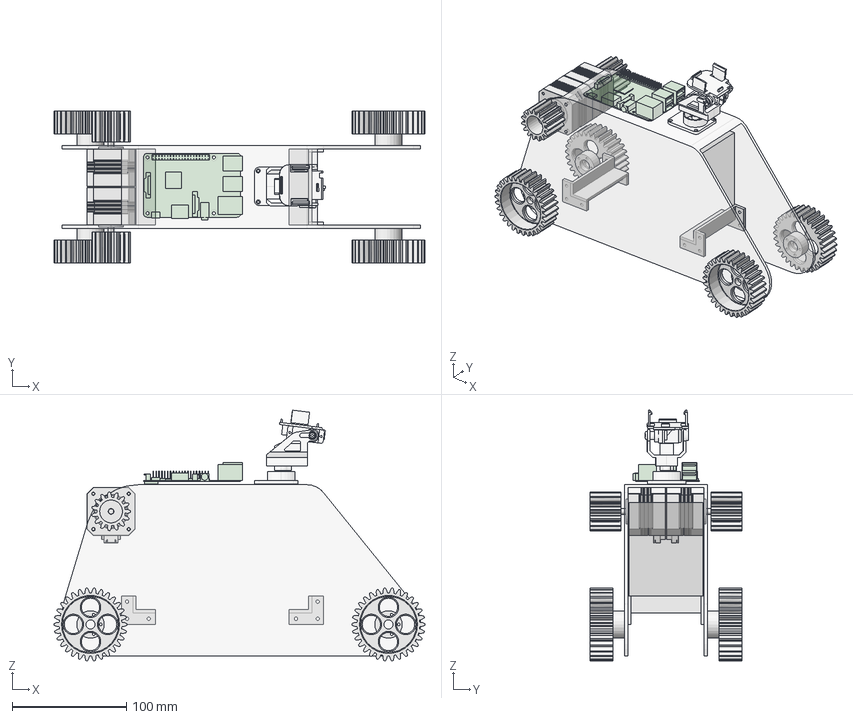
[picture p102: CAD file, 2018-04-22, an earlier design]
preprojeto/modelo3d/modelo.fcstd
325.0 x 133.0 x 219.6 mm
Bateria 12MVA-7
chassi-motor
suporte-bateria
suporte
suporte_camera
motor_transmissao_direito
mancais
motor_transmissao_esquerdo
polias-esquerda
polias-direita
Cut015 (Mirror #6)
