raffsalvetti/ENGG60/projeto/figuras/pwm2.pdf

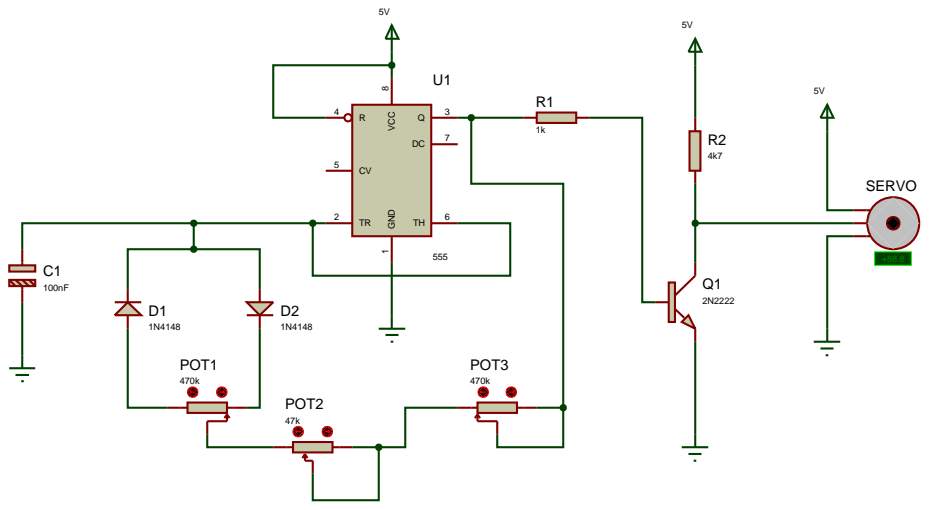
[picture p108: page 1]
GND 1 VCC 8; SERVO; POT1; POT3; POT2
