raffsalvetti/ENGG60/board/hat.pdf

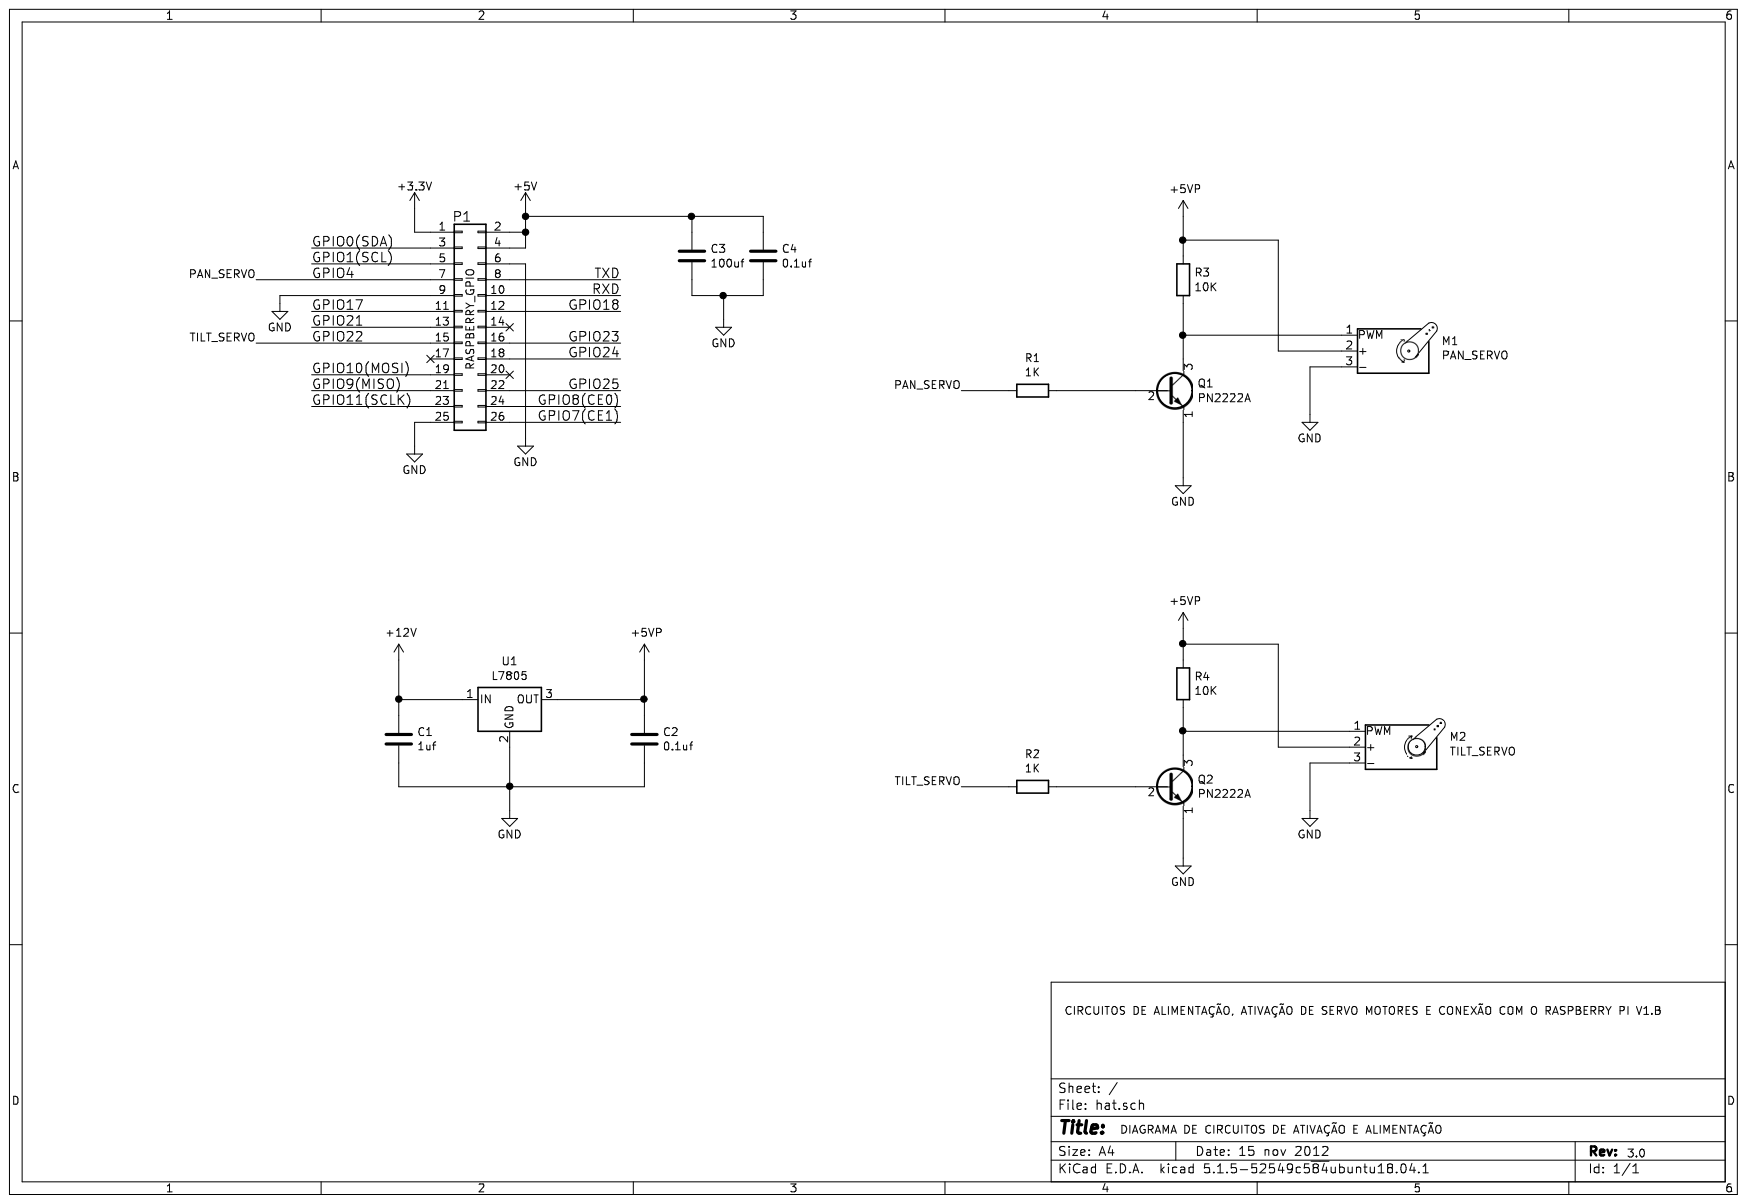
[picture p109: page 1]
