raffsalvetti/ENGG60/projeto/figuras/camdemo_inc.pdf

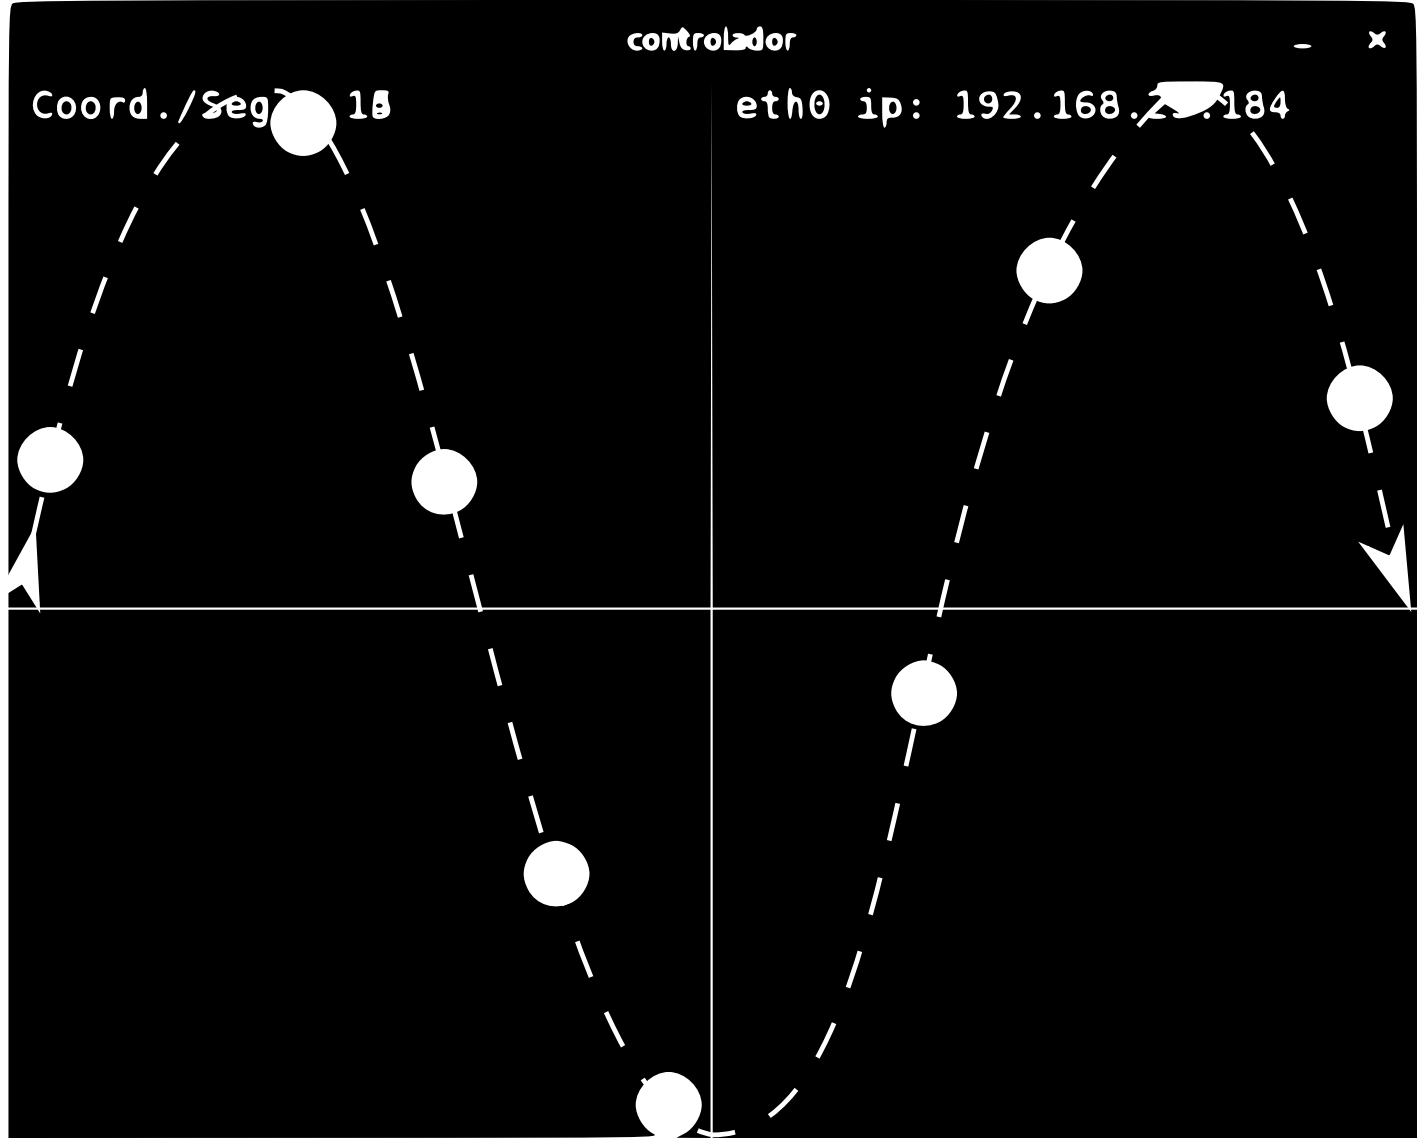
[picture p110: page 1]
