raffsalvetti/ENGG60/projeto/figuras/android_sys_arch.pdf

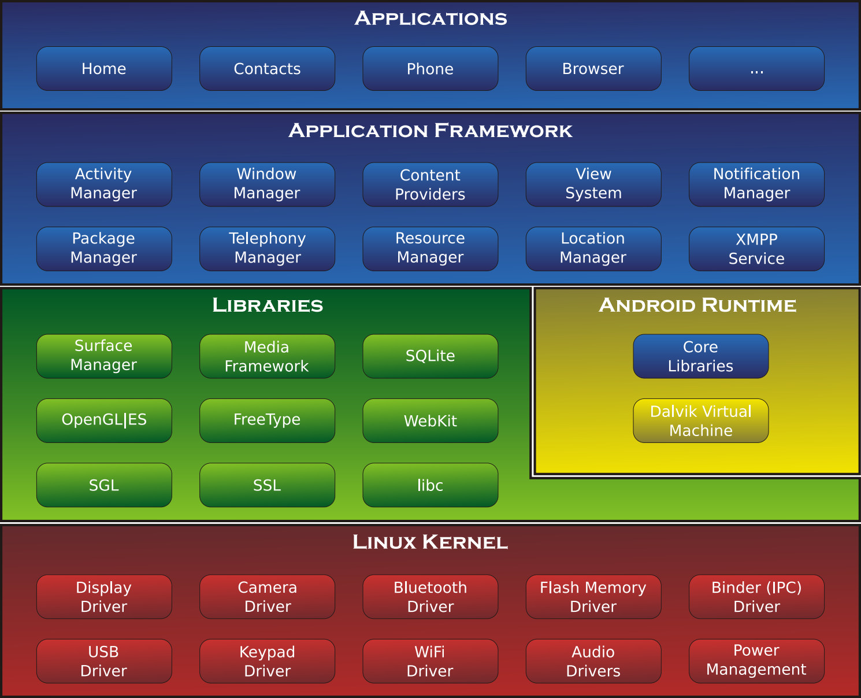
[picture p111: page 1]
