raffsalvetti/ENGG60/(list of files, drawings)

Other design files:
Simulacao/acionamento.dsn
Simulacao/fonte_motores.DSN
Simulacao/pwm2.dsn
Simulacao/pwm.dsn
