raffsalvetti/ENGG60/board/hat/hat.sch

## KiCad design board/hat/hat.sch (2019-11-30)

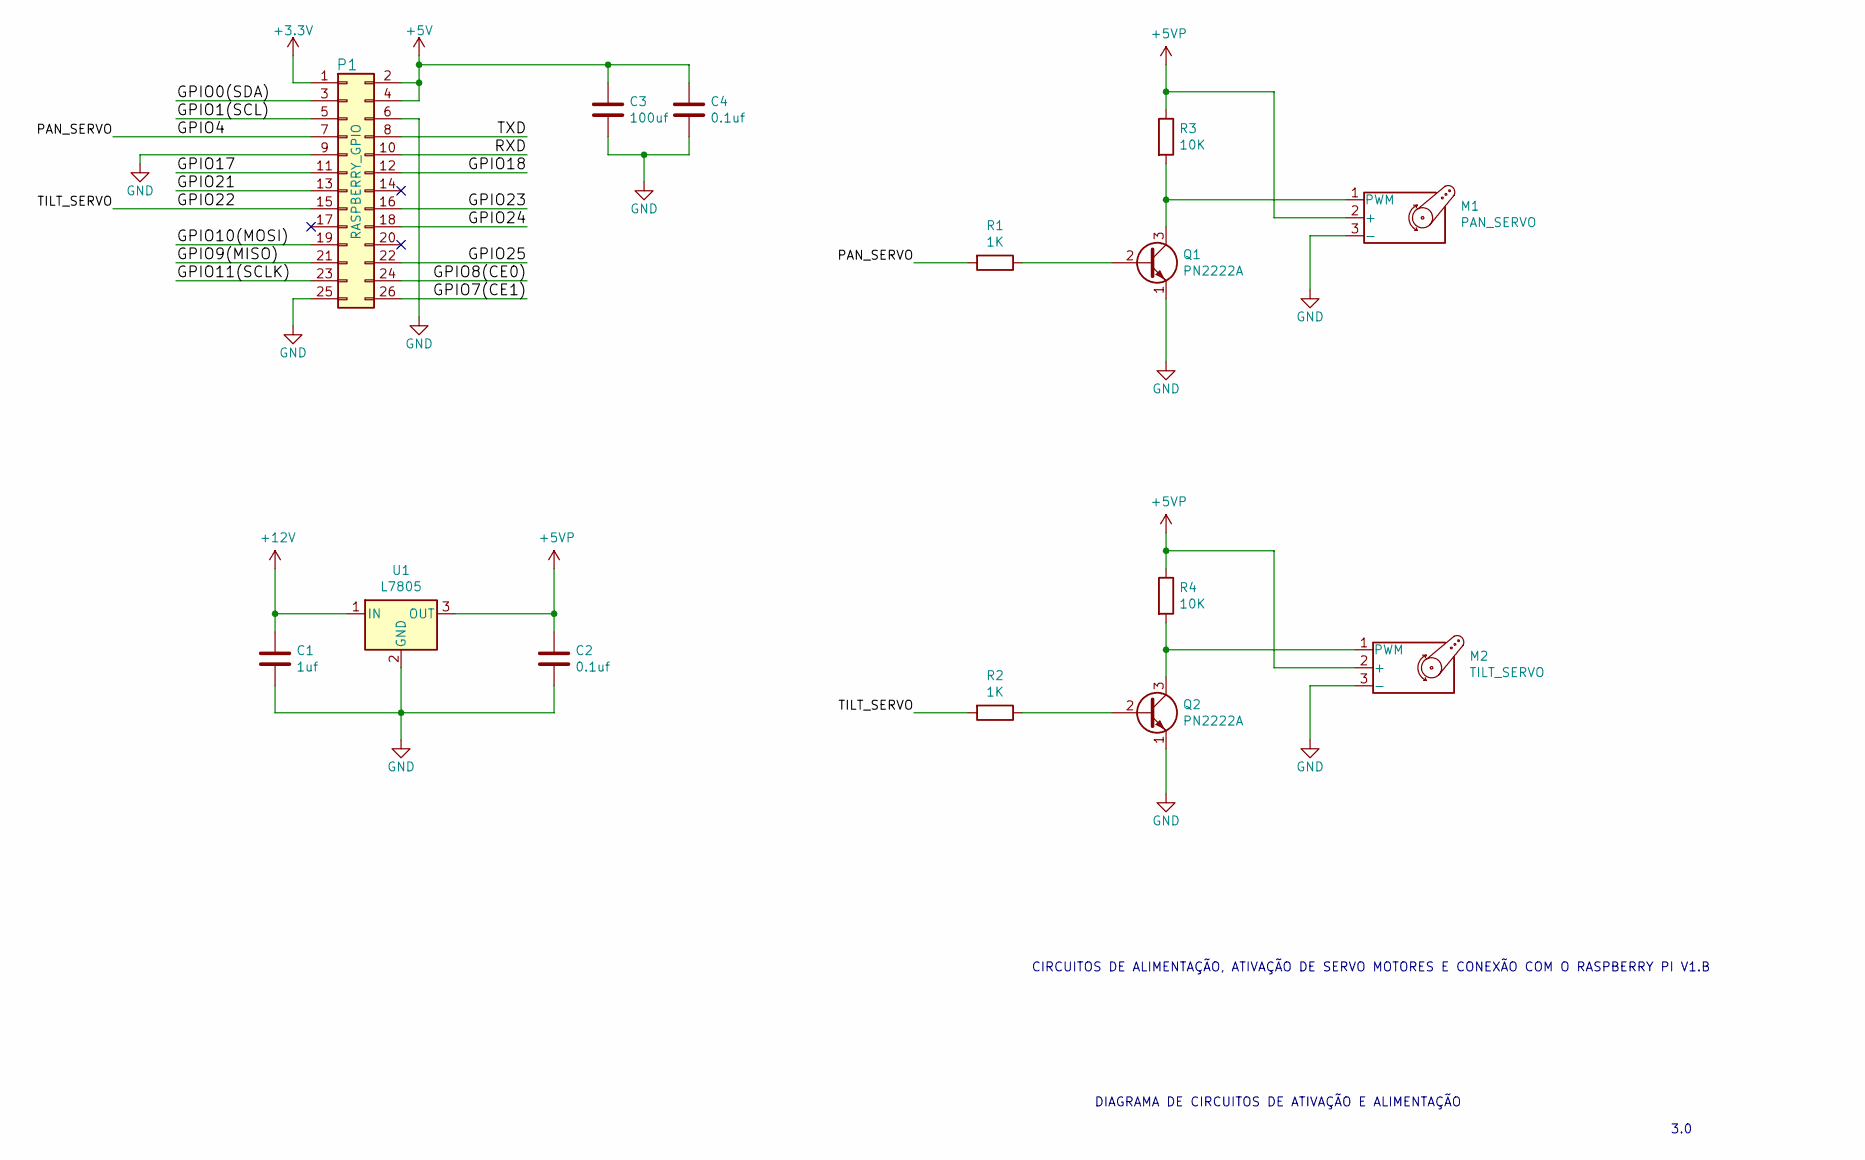
[picture p112: schematic hat.sch]

Parts:
C1: 1uf
C2, C4: 0.1uf
C3: 100uf
M1: PAN_SERVO
M2: TILT_SERVO
P1: RASPBERRY_GPIO; PinHeader_2x13_P2.54mm_Vertical
Q1, Q2: PN2222A; TO-92_Inline
R1, R2: 1K
R3, R4: 10K
U1: L7805

Connections:
+3.3V: P1.1
+5V: C3.1, C4.1, P1.2, P1.4
+5VP: C2.1, M1.2 (+), M2.2 (+), R3.1, R4.1, U1.3 (OUT)
+12V: C1.1, U1.1 (IN)
GND: C1.2, C2.2, C3.2, C4.2, M1.3 (-), M2.3 (-), P1.6, P1.9, P1.25, Q1.1 (E), Q2.1 (E), U1.2 (GND)
GPIO0(SDA): P1.3
GPIO1(SCL): P1.5
GPIO4: P1.7, R1.2
GPIO7(CE1): P1.26
GPIO8(CE0): P1.24
GPIO9(MISO): P1.21
GPIO10(MOSI): P1.19
GPIO11(SCLK): P1.23
GPIO17: P1.11
GPIO18: P1.12
GPIO21: P1.13
GPIO22: P1.15, R2.2
GPIO23: P1.16
GPIO24: P1.18
GPIO25: P1.22
unnamed: M1.1 (PWM), Q1.3 (C), R3.2
unnamed: M2.1 (PWM), Q2.3 (C), R4.2
unnamed: Q1.2 (B), R1.1
unnamed: Q2.2 (B), R2.1
RXD: P1.10
TXD: P1.8

Notes on the sheet:
DIAGRAMA DE CIRCUITOS DE ATIVAÇÃO E ALIMENTAÇÃO
3.0
CIRCUITOS DE ALIMENTAÇÃO, ATIVAÇÃO DE SERVO MOTORES E CONEXÃO COM O RASPBERRY PI V1.B
