raffsalvetti/ENGG60/(commit log)

2018-04-15 adicionado modelo 3d + adicionado conteudo
    [Raspberry Pi (V.1.2) B+.STEP, RuncamSwiftMicro PanTilt-1.stp, modelo.fcstd, pantilt.STEP]
2018-04-16 adicionado conteudo
    [chain.STEP, modelo.fcstd]
2018-04-20 adicionado modelo de motores + modificado modelo3d
    [JLB Stepper Motor 17HS1352-P4130.STEP, NEMA Stepper.STEP, modelo.fcstd]
2018-04-22 modificado modelo 3d
    [modelo.fcstd]
2018-04-22 modificado engrenagem das correntes
    [modelo.fcstd]
2018-04-22 adicionado engrenagem dos motores
    [modelo.fcstd]
2019-03-24 adicionado projeto de teste para captura de movimentos da cabeca - android + adicionado projeto de teste para stream de video no raspberry
2019-03-27 testes com sensores
2019-03-28 teste sensor
2019-03-29 testes sensores
2019-04-03 adicionado filtro de media movel + testes com sensores
2019-04-04 adicionado teste de cliente de rede udp no android e servidor udp em python
2019-04-05 testes com vetor + melhorias no servidor python + adicionado visualizador de posicao usando pygame
2019-04-08 adicionado mensagem broadcast para encontrar o servidor
2019-05-02 preprojeto modificado. escopo menor. diagrama de blocos atualizado
2019-05-03 impressao de documentos
2019-08-31 adicionado programa de teste em c para substituir o script em python
    [modelo_v2.0.fcstd]
2019-09-03 adicionado controle de servo; adicionado referencias; adicionado classe de controle para orientacao no android; adicionado informacoes no display de testes
2019-09-07 corrigido bug que nao enviava os pulsos para os servos usando o dispositivo servoblaster
    [display.c, server.c, servo.c]
2019-09-08 adicionado mecanismo de descoberta de ip do controlador; teste de cliente de stream de video para android
2019-10-16 adicionado modelo do projeto; adicionado programa de controle de camera usando servoblaster
    [modelo_v2.0.fcstd]
2019-10-16 adicionado teste com stream de video; adicionado referencias para motores
2019-10-19 organizacao de referencias
2019-10-20 artigos renomeados; adicionado parte de introducao; adicionado parte de fundamentacao teorica
2019-10-28 limpeza de projeto
2019-11-04 adicionado referencias; adicionado conteudo
    [acionamento.dsn, pwm.dsn]
2019-11-06 adicionado simulacao pwm
    [pwm.dsn, pwm2.dsn]
2019-11-12 adicionado conteudo; adicionado imagens; adicionado simulacao de circuito de fonte
    [fonte_motores.DSN]
2019-11-16 adicionado conteudo; implementado controle de video; adicionado imagens; ajustes em servidor para informar ip do cliente; ajustes na main para enviar ip do cliente para o servidor de video; ajustes n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
    [pwm2.dsn]
2019-11-18 adicionado conteudo; adicionado imagens; adicionado script de instalacao do raspbian
    [hat.kicad_pcb, hat.sch]
2019-11-20 adicionado prototipo de lista de simbolos; adicionado prototipo de lista de siglas; ajuste de conteudo; adicionado conclusao parcial; adicionado resultados parcial
    [pwm2.dsn]
2019-11-22 adicionado funcao de circunferencia; ajustado defines na main
2019-11-23 ajuste de pino para motor x; adicionado script para construcao
2019-11-23 adicionado funcao de calibracao de camera; ajuste em conclusao
2019-11-30 adicionado imagens; adicionado conteudo; adicionado agradecimentos; adicionado abstract
    [hat.kicad_pcb, hat.sch]
2019-12-01 correcao de palavras
2019-12-05 adicionado apresentacao; adicionado imagens; adicionado calibracao de camera no app do celular; finalizado documento de tcc
